halworsen/tdt4295-grafikk/pcb/tdt4295/symlib/kicad-ext-lib/folder description.txt

SN74ALVC245PWR = Octal bus transceiver (for VGA)
BKP2125HS221-T = Ferrite bead, 220 Ohm

Diode_Wurth_150060YS75000 = LED
NUP4114UCW1T2G = TVS diode (ESD)
S25FL127SABMFV101 = Quad-SPI flash

CAPACITORS
T520V337M2R5ATE025 = 330uF

DSC1001AL5-100.0000 = 100MHz clock
