halworsen/tdt4295-grafikk/component documentation/pcbdesign-lecture.pdf

Institutt for datateknologi og informatikk, NTNU

# TDT4295 DATAMASKINER PROSJEKT

## Kretskortutlegg

2021-09-14

## Typisk fremgangsmåte

### 1. Bestem funksjonalitet

I Overordnet skisse over hovedkomponenter

### 2. Bestem hovedkomponenter 3. Tegn skjema for systemet

I Bestem resten av komponentene

### 4. Tegn kretskort

1

## Funksjonalitet

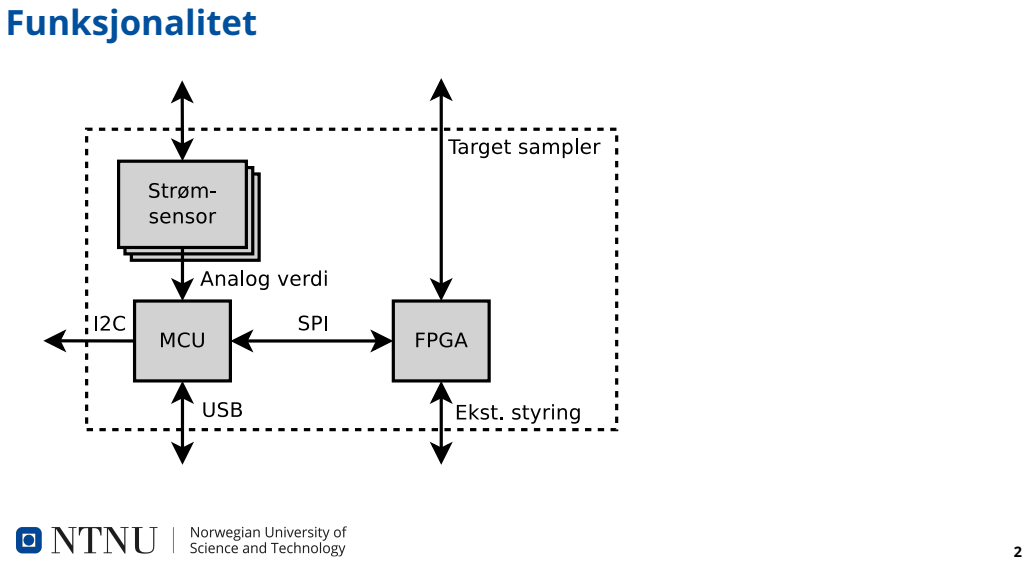
[picture p3: page 3]

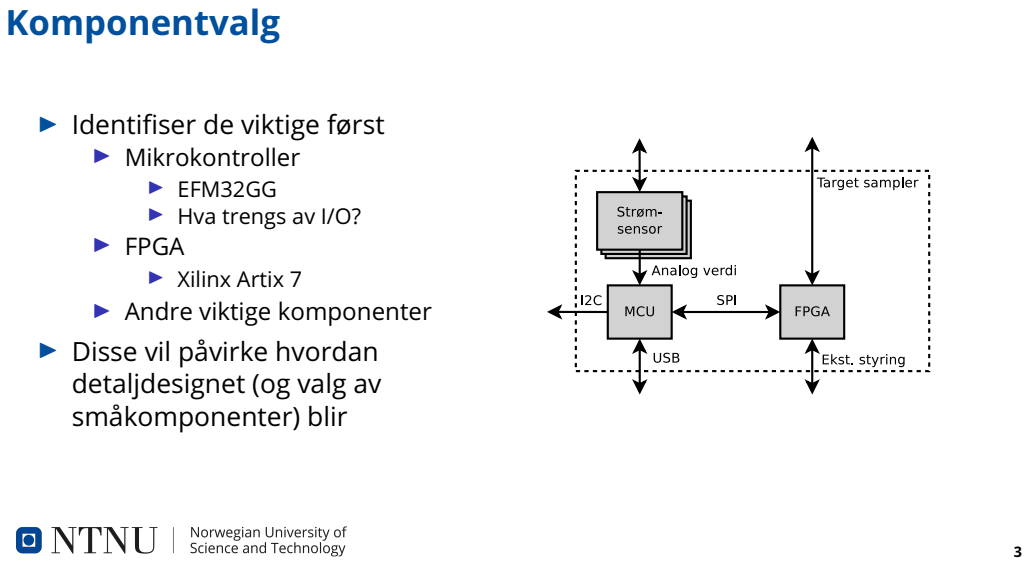
[picture p4: page 4]

Komponentvalg I Identifiser de viktige først I Mikrokontroller I EFM32GG I Hva trengs av I/O? I FPGA I Xilinx Artix 7 I Andre viktige komponenter I Disse vil påvirke hvordan

detaljdesignet (og valg av
småkomponenter) blir

## Komponentvalg

Velg komponenter som er lette å bruke:
I Noen komponenter krever kompliserte støttekretser og / eller komplisert PCB-utlegg
I Noen komponenter kan være vanskelige å skrive programvare for
I Finnes driver som kan brukes?
I Pass på at komponentene faktisk er kompatible med andre komponenter de skal kommunisere med
I Spenningsnivåer: Prøv å holde dere til 3.3V for alle signaler
I Kommunikasjonsstandarder (SPI/I2C/...)
I Les og forstå datablader

4

## Komponentvalg

Velg komponenter som er lette å lodde:
I Samme komponent kan komme i forskjellige pakker I Lette å lodde:
I QFP
I SOIC / *SOP etc
I SOT
I Vanskelige å lodde:
I BGA
I QFN
I Velg stor pitch (avstand mellom pinner/ben)
I Helst 0.5mm eller mer (gjerne 1mm på BGA)
I For motstander/kondensatorer etc:
I Følg databladenes anbefalinger hvis det er angitt I Velg gjerne 0805 eller 1206 som standard
I Unngå mindre enn 0603

5

## Komponentvalg

Velg komponenter som er lette å få tak i:
I Sjekk tilgjengelighet på farnell.no og digikey.no
I Dere har ikke tid til å vente månedsvis på ukurante komponenter

6

## Skjemategning

I KiCAD Eeschema
I Symbolsk sammenkobling av komponenter
I Spesifiserer hvordan komponenter kobles sammen
I Sier ingenting om fysisk plassering, banebredde etc.
I Den viktigste designjobben gjøres her
I Nettlista (informasjon om sammenkobling av komponenter) kan senere overføres til PCB-verktøyet hvor fysisk design gjøres

7

## Skjemategning

I Følg eksempelskjema i datablader
I Det finnes nesten alltid et eksempel som kan kopieres I Bruk hierarkiske bokser/underskjema:
I Mikrokontroller
I FPGA
I Strømforsyning
I ...
I Kjør ERC (Electrical Rules Checker) før dere overfører nettlista til PCB-verktøyet

8

## Symboler

I Symboler representerer en PCB-komponent i skjemaverktøyet I KiCAD har symboler for mange komponenter
I Må du tegne nytt symbol:
I Pass på at pinnenummerering blir korrekt

9

## Avkoblingskondensatorer

I Generelt trenger alle brikker en eller flere avkoblingskondensatorer I Disse skal helst plasseres så nært VCC-pinnene som mulig (på PCB, i skjemategningen spiller det ingen rolle)
I Sørger for å holde VCC konstant selv ved kortvarig høyt strømtrekk I Dette er spesifisert i databladene; kopier eksempelet fra databladet

10

## Ta høyde for feil

I Legg til noen testpunkter for måleutstyr
I Men ikke på raske busser, kan ødelegge signalintegritet I Rut noen ledige GPIO-pinner ut på pin-headere
I Gir fleksibilitet
I Både fra FPGA og mikrokontroller

11

## Koble symbol til footprint

I Når skjemaet er ferdig må alle symboler tilordnes et footprint
I Footprints er den fysiske representasjonen av komponenten
I Inneholder loddpunkter, hull og tekst/grafikk som trykkes på kretskortet
I Hvert symbol i skjemategningen må tilknyttes et footprint som skal brukes i PCB-verkstøyet
I Må du tegne nytt footprint:
I Vær nøyaktig
I Pass på å ikke speilvende pinner
I Følg datablad
I Skriv ut og sjekk at komponenten passer fysisk og at dere har store nok loddepunkter til håndlodding

12

## Kretskortutlegg

I KiCAD: Pcbnew
I Fysisk utlegg av kretskortet
I Plassere komponenter
I Ruting (tegne ledere mellom komponenter)
I Bruker informasjon fra skjemaet slik at man er sikret mot feilkoblinger

13

## PCB: Oppsett av kort

Sett opp antall lag: Bruk 4–8 lag
I Ett internt jordingslag
I Minst ett internt VCC-lag
I Minst to signallag (topp og bunn) I Antall lag:
I Få lag: Billig.
I Mange lag: Lettere å rute
I FPGA er vanskelig å rute med bare 4 lags kort

14

## PCB: Oppsett av kort

Sett opp design rules i KiCAD. Hent info fra fabrikk (https://www.elprint.no/Kapabilitet) eller bruk følgende: I Clearance: 0,125 mm
I Track width: 0,125 mm
I Via dia: 0,6 mm
I En via er en sammenkobling av baner på ett lag til et annet lag I Via drill: 0,3 mm
Det meste kan lages, men husk at smått er dyrt.

15

## PCB: Komponentplassering

I Plasser ut alle footprints manuelt
I Tegn omrisset av kortet når komponentene er plasserte I Ikke lag for lite kort, vanskelig å lodde og debugge
I Tenk nøye gjennom plassering og rotasjon
I Har mye å si for hvor lett ruting blir senere
I Ikke plasser for tett
I Det gir vanskelig ruting og vanskelig lodding
I Grupper komponenter i forhold til skjemategningene I Følg databladenes retningslinjer

16

## PCB: Ruting

I Anbefaler manuell ruting
I Autoruteren gir neppe godt resultat
I Helst ikke bruk minimum banebredde hvis det ikke er nødvendig I Sett opp en standardbredde for signaler, og noen tykkere baner for strømforsyning
I Ikke bruk “buried” eller “blind” via. Bare bruk vanlig through-hole via. I Ikke ha via i en pad

17

## PCB: Signalintegritet

I Plasser krystaller og oscillatorer nær brikkene som bruker de I Hold “høyhastighets”-busser korte og uten hindringer
I Ikke rut disse via en konnektor eller pinheader
I Eksempel: SPI-buss mellom mikrokontroller og FPGA

18

## PCB: Analog og digital

I For minimalt med støy bør eventuell analogdel separeres fra støyende digitale deler
I Legg analogdelen ut mot en kant av PCB
I Ikke mellom strømforsyning og digitaldel
I Vanlig å ha egen VCC for analogdel (se EFM32 AN0002 for eksempel på isolering av analog VCC)
I Stort og komplisert tema
I Ikke noe vi ønsker dere skal bruke mye tid på
I For f.eks audio vil alt fungere (muligens med dårligere lydkvalitet) selv om dere ignorerer alle analog-råd

19

## PCB: Ferdigstillelse

I Fyll alle plan
I De interne jord- og VCC-lagene er såkalte “plan”, store fylte områder med kobber
I Sjekk at ikke via har ødelagt noen av planene
I Kjør DRC (Design Rules Checker)
I Skriv ut på papir og sjekk at:
I komponenter passer fysisk
I det er plass til å lodde

20

## EFM32GG

I Generelt lett å bruke
I Strømforsyning: 3.3V
I Klokke: Kan bruke intern oscillator, eller ekstern krystall I Anbefaler 48MHz ekstern krystall
I Velg den som har de egenskapene dere trenger
I I/O
I Flash (men ingen grunn til å være gjerrig på flash)
I Husk JTAG-konnektor
I Relevante dokumenter:
I SiLabs EFM32 AN0002 (Hardware Design Considerations) I Bruk helst pakke QFP64

21

## EFM32GG

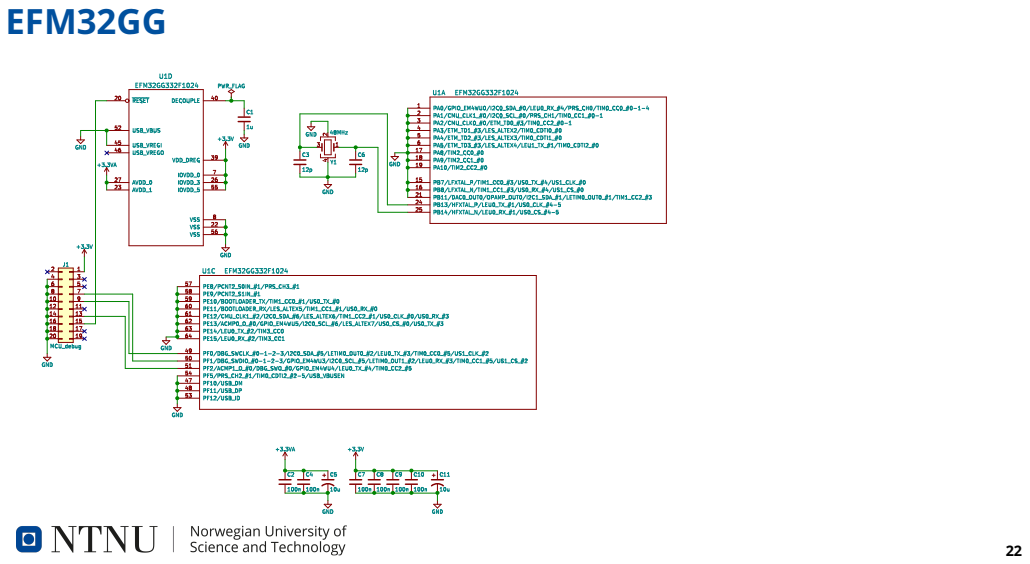
[picture p5: page 23]

## Xilinx Artix 7 FPGA

I Kompleks chip
I Krever mye støtte på kretskortet
I Kompleks strømforsyning
I Mange avkoblinskondensatorer
I Egen Flash-brikke til å lagre konfigurasjonen
I JTAG-konnektor
I Bruk helst pakke FTG256 (også kjent som 256-LBGA)

23

## Artix 7 – Relevante dokumenter

I UG483: 7 Series FPGAs PCB Design Guide
I Her finner dere bl.a. info om avkoblingskondensatorer I XAPP586: Using SPI Flash with 7 Series FPGAs
I Hvordan koble opp Flash-brikken og JTAG-konnektor I UG908: Vivado Design Suite User Guide
I Appendix C har liste over støttede Flash-brikker
I Mindre relevante dokumenter:
I UG470: 7 Series FPGAs Configuration
I Mer om JTAG og konfigurering

24

## Artix 7 – Strømforsyning

I Krever 3 spenninger: 1.0V, 1.8V, 3.3V
I Disse må dere skru på i korrekt rekkefølge
I Switching converter (buck converter) eller lineær? I Switching er mer energieffektiv
I Lineær er enklere å bruke
I Lineær støyer mindre

25

## Artix 7 – Eksempel på strømforsyning

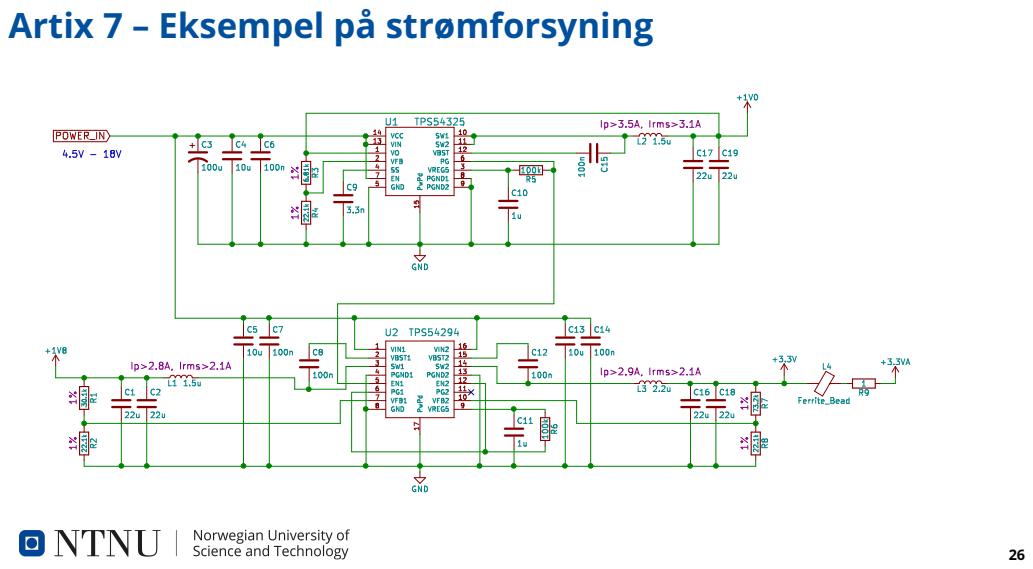
[picture p6: page 27]

## TPS54294 utlegg

27

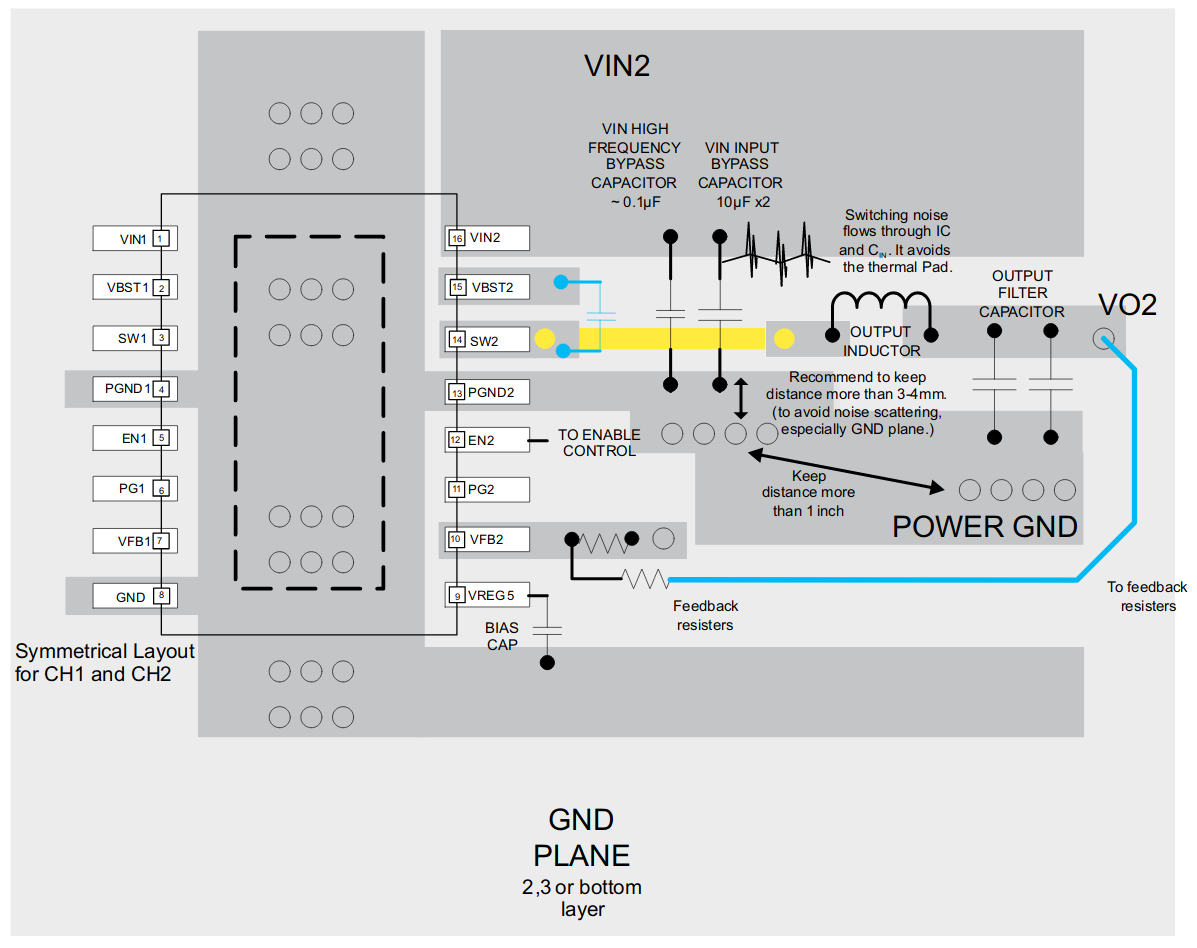
[picture p7: figure]

## Artix 7 – Avkoblingskondensatorer

I Krever mange avkoblingskondensatorer
I Størrelser, antall og maks avstand fra brikken spesifisert i UG483
I En mulighet er å plassere disse på undersiden av kortet, for å oppfylle distansekrav

28

## Artix 7 – Flash

I FPGA trenger en separat Flash-brikke for å lagre konfigurasjonen I Velg en SPI Flash som er kompatibel:
I Velg fra appendix C i UG908
I Kopier skjema fra XAPP586

29

## Artix 7 – JTAG og Reset

I Koble opp som i XAPP586
I Legg til 10k pullup-motstand på TMS og TCK for å hindre problemer når JTAG-kabel ikke er plugget i
I Pullup-motstand er en motstand koblet opp mot VCC. Sørger for at linja er høy hvis ikke noe annet driver den lav.

30

## Artix 7

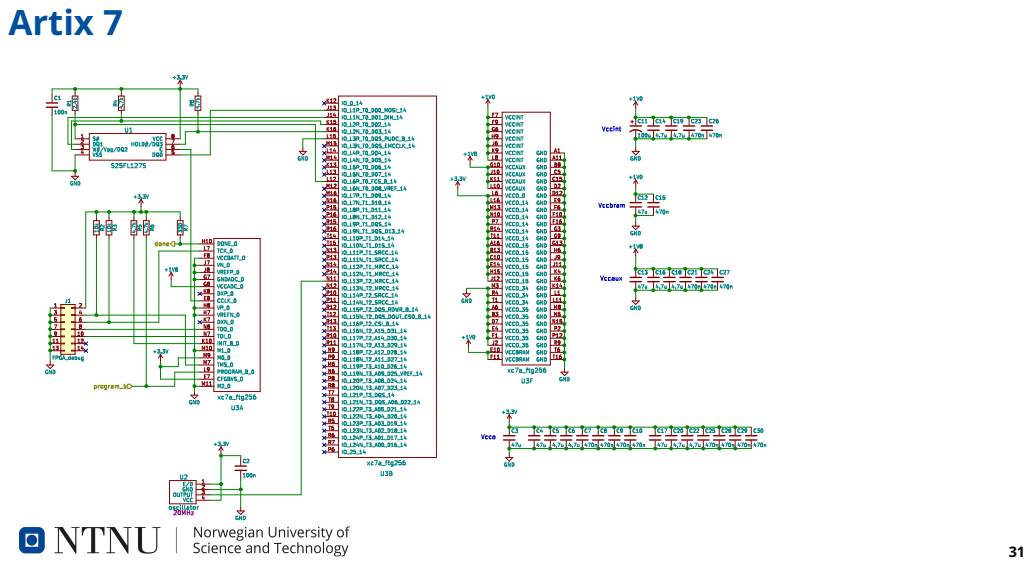
[picture p8: page 32]
