halworsen/tdt4295-grafikk/component documentation/giant-gecko/stk_docs/brd2200/BRD2200A_A03_bom.xlsx

P/N: | BRD2200A
Revision: | A03
Description: | EFM32 Giant Gecko Starter Kit
Revised: | Tuesday, May 15, 2012
Item | Quantity | Reference | Part | Manufacturer | Manufacturers Part Number | Footprint | Tolerance | Rating | Technology | NotMounted | Price1K | Hapro Art.nr | Price_tot
1 | 5 | C100,C101,C718,C1001,C1003 | 1N | Murata | GRM155 | T_0402 |  | 16V | X7R |  | 0.003 |  | 0.015
2 | 44 | C103,C104,C106,C199,C403,C408,C409,C410,C411,C412,C419,C600,C603,C604,C605,C606,C660,C680,C701,C702,C704,C706,C707,C710,C721,C728,C730,C800,C802,C803,C804,C805,C806,C807,C808,C891,C904,C910,C911,C912,C913,C914,C916,C917 | 100N | Murata | GRM155 | T_0402 |  | 16V | X7R |  | 0.003 |  | 0.132
3 | 16 | C105,C404,C415,C423,C601,C607,C700,C703,C714,C719,C720,C725,C731,C732,C907,C915 | 10U | Murata | GRM21 | T_0805 |  | 10V | X5R |  | 0.03 |  | 0.48
4 | 1 | C198 | 330P | Murata | GRM155 | T_0402 |  | 50V | C0G |  | 0.003 |  | 0.003
5 | 1 | C200 | 30mF | Tayio Yuden | PAS311HR-VA6R | TAIYO_YUDEN_311_VA6R |  | 3.3V |  |  | 0.335 |  | 0.335
6 | 1 | C250 | 100N | Murata | GRM188 | T_0603 |  | 16V | X7R | NM | 0.003 |  | 0
7 | 4 | C400,C401,C420,C501 | 1U | Murata | GRM18 | T_0603 |  | 10V | X5R |  | 0.006 |  | 0.024
8 | 1 | C402 | 4U7 | Murata | GRM21 | T_0805 |  | 25V | X5R |  | 0.046 |  | 0.046
9 | 6 | C405,C406,C890,C905,C908,C909 | 10N | Murata | GRM155 | T_0402 |  | 16V | X7R |  | 0.013 |  | 0.078
10 | 2 | C417,C418 | 7P5 | Murata | GRM15 | T_0402 |  | 50V | C0G |  | 0.005 |  | 0.01
11 | 4 | C421,C422,C900,C901 | 18P | Murata | GCM155 | T_0402 |  | 50V | C0G |  | 0.003 |  | 0.012
12 | 1 | C500 | 22N | Murata | GRM155 | T_0402 |  | 16V | X7R |  | 0.003 |  | 0.003
13 | 2 | C602,C705 | 33N | Murata | GRM155 | T_0402 |  | 16V | X7R |  | 0.003 |  | 0.006
14 | 2 | C724,C920 | 100N | Murata | GRM155 | T_0402 |  | 16V | X7R |  | 0.013 |  | 0.026
15 | 1 | C729 | 10N | Murata | GRM155 | T_0402 |  | 16V | X7R | NM | 0.013 |  | 0
16 | 2 | C902,C903 | 12P | Murata | GCM155 | T_0402 |  | 50V | C0G |  | 0.003 |  | 0.006
17 | 2 | C1002,C1004 | 10P | Murata | GRM155 | T_0402 |  | 50V | C0G |  | 0.003 |  | 0.006
18 | 2 | D400,D600 | IP4220CZ6 | NXP Semiconductors | IP4220CZ6,125 | SOT457 |  |  |  |  | 0.1 |  | 0.2
19 | 1 | D800 | VESD05A8A-HNH | Vishay Semiconductors | VESD05A8A-HNH | LLP1713-9L |  |  |  |  | 0.25 |  | 0.25
20 | 1 | J100 | 1X5 2.54MM | FCI | 68000-408HLF | HEADER5X1_2.54MM_TH |  |  |  | NM | 0.11 |  | 0
21 | 1 | LCD1 | CL010-1087-04 | Tri-T Co Ltd | CL010-1087-04 | LCD_TRI-T_CL010-1087-03 |  |  |  |  | 2.2 |  | 2.2
22 | 3 | LED100,LED101,LED900 | YELLOW | Würth Electronics | 150060YS75000 | LED_0603 |  |  |  |  | 0.019 |  | 0.057
23 | 1 | LED901 | BLUE | Panasonic | LNJ926W8CRA | LED_0603 |  |  |  |  | 0.247 | 9141170 | 0.247
24 | 1 | LED903 | RED | Würth Electronics | 150060RS75000 | LED_0603 |  |  |  |  | 0.028 |  | 0.028
25 | 1 | LED904 | LED_G_R | Avago | HSMF-C165 | AVAGO_HSMF_C165 |  |  |  |  | 0.133 | 9141206 | 0.133
26 | 1 | L100 | 390UH | Würth Electronics | S11100017 | SDR0302 |  |  |  |  | 0.072 |  | 0.072
27 | 8 | L400,L700,L730,L780,L800,L801,L900,L1001 | CBF102WB | Würth Electronics | 74279266 | WURTH_CBF_0603 |  |  |  |  | 0.017 |  | 0.136
28 | 3 | L401,L402,L600 | CBF221HC | Würth Electronics | 742792022 | COIL_MUR_BLM21_0805 |  |  |  |  | 0.017 |  | 0.051
29 | 1 | M1 | HOLE_PTH_3MM |  |  | 3MM_PLATED |  |  |  | NM |  |  | 0
30 | 2 | M2,M3 | HOLE_TH_3MM |  |  | 3MM_NONPLATED |  |  |  | NM |  |  | 0
31 | 1 | PCB1 | PCB2200 |  | PCB2200 Rev. A03 | N/A |  |  |  |  |  |  | 0
32 | 1 | P100 | HEADER_2X10_2.54MM_HOR_SMD | Taitek | HE2-20G6C394-5R | HEADER_2X10_2.54MM_HOR_SMD |  |  |  |  | 0.71 |  | 0.71
33 | 1 | P200 | HEADER_2X10_1.27MM_SMD | Sullins | GRPB102VWQS | HEADER_2X10_1.27MM_SMD |  |  |  | NM | 0.73 | 9322374 | 0
34 | 1 | P400 | USB_Micro_AB | Hirose Electric Co Ltd | ZX62-AB-5PA(11) | ZX62-AB-5PA_11 |  |  |  |  | 0.5 |  | 0.5
35 | 1 | P601 | WR_COM_USB_MINI_B | Würth Electronics | 651 005 161 21 | WURTH_USB_65100516121 |  |  |  |  | 0.242 |  | 0.242
36 | 1 | P700 | COIN_CELL | Keystone | 3002 | KEYSTONE_3002 |  |  |  |  | 0.23 |  | 0.23
37 | 1 | P800 | HEADER_2.54MM_SMD_SHROUD | Würth Electronics | 612 3 020 206 21 | HEADER_2X10_2.54MM_SMD_SHROUD |  |  |  |  | 0.674 |  | 0.674
38 | 1 | P900 | HEADER_2X10_2.54MM_SMD | FCI | 95278-801A20LF | HEADER_2X10_2.54MM_SMD |  |  |  | NM | 0.73 |  | 0
39 | 1 | Q1 | BSS138W | Diodes Inc. | BSS138W-7-F | SOT323 |  |  |  |  | 0.07 |  | 0.07
40 | 1 | Q100 | TEMT6200FX01 | Vishay | TEMT6200FX01A | T_0805 |  |  |  |  | 0.41 |  | 0.41
41 | 1 | Q702 | BC846BWT1G | ON Semiconductor | BC846BWT1G | SC70_SOT323 |  |  |  |  | 0.046 |  | 0.046
42 | 1 | Q703 | NTS210 | ON Semiconductor | NTS2101PT1G | SC-70 |  |  |  |  | 0.12 |  | 0.12
43 | 2 | RP800,RP801 | 33R | ROHM | MNR04M0APJ330 | RES_MNR04-8 |  |  |  |  | 0.0122 |  | 0.0244
44 | 8 | R100,R103,R246,R401,R728,R730,R750,R810 | 100R |  |  | T_0402 |  |  |  |  | 0.005 |  | 0.04
45 | 12 | R101,R102,R106,R407,R409,R680,R681,R682,R686,R687,R708,R815 | 1M |  |  | T_0402 |  |  |  |  | 0.005 |  | 0.06
46 | 6 | R104,R607,R608,R774,R807,R808 | 4K7 |  |  | T_0402 |  |  |  |  | 0.005 |  | 0.03
47 | 12 | R105,R603,R604,R605,R606,R729,R802,R803,R804,R809,R890,R891 | 100K |  |  | T_0402 |  |  |  |  | 0.005 |  | 0.06
48 | 3 | R107,R108,R900 | 3K |  |  | T_0402 |  |  |  |  | 0.005 |  | 0.015
49 | 2 | R196,R901 | 1K5 |  |  | T_0402 |  |  |  |  | 0.005 |  | 0.01
50 | 6 | R198,R408,R704,R779,R915,R916 | 0R |  |  | T_0402 |  |  |  |  | 0.005 |  | 0.03
51 | 1 | R199 | 22K |  |  | T_0402 |  |  |  |  | 0.005 |  | 0.005
52 | 4 | R240,R243,R244,R245 | 10K |  |  | T_0603 |  |  |  | NM | 0.005 |  | 0
53 | 2 | R241,R242 | 0R |  |  | T_0603 |  |  |  |  | 0.005 |  | 0.01
54 | 3 | R403,R731,R910 | 1R |  |  | T_0402 |  |  |  |  | 0.005 |  | 0.015
55 | 2 | R405,R406 | 15R |  |  | T_0402 |  |  |  |  | 0.005 |  | 0.01
56 | 1 | R410 | 0R |  |  | T_0402 |  |  |  | NM | 0.005 |  | 0
57 | 6 | R600,R609,R612,R700,R800,R914 | 10K |  |  | T_0402 |  |  |  |  | 0.005 |  | 0.03
58 | 3 | R601,R611,R702 | 180K |  |  | T_0402 |  |  |  |  | 0.005 |  | 0.015
59 | 2 | R602,R703 | 110K |  |  | T_0402 |  |  |  |  | 0.005 |  | 0.01
60 | 2 | R610,R814 | 10M |  |  | T_0402 |  |  |  |  | 0.005 |  | 0.01
61 | 1 | R701 | 4R7 | Bourns | CRT1206-BY-4R7-ELFTR | T_1206 | 0.10% |  |  |  | 0.15 | 9170471 | 0.15
62 | 5 | R705,R772,R792,R919,R920 | 1K |  |  | T_0402 |  |  |  |  | 0.005 |  | 0.025
63 | 1 | R706 | 15K |  |  | T_0402 |  |  |  |  | 0.005 |  | 0.005
64 | 1 | R707 | 33K |  |  | T_0402 |  |  |  |  | 0.005 |  | 0.005
65 | 2 | R709,R710 | 1K8 | YAGEO | RT0603BRD071K8L | T_0603 | 0.10% |  |  |  | 0.036 |  | 0.072
66 | 1 | R717 | 10R |  |  | T_0402 |  |  |  |  | 0.005 |  | 0.005
67 | 1 | R718 | 12K | YAGEO | RT0603BRD0712KL | T_0603 | 0.10% |  |  |  | 0.036 |  | 0.036
68 | 2 | R727,R801 | 47K |  |  | T_0402 |  |  |  |  | 0.005 |  | 0.01
69 | 4 | R732,R781,R805,R806 | 33R |  |  | T_0402 |  |  |  |  | 0.005 |  | 0.02
70 | 1 | R760 | 330K |  |  | T_0603 | 1% |  |  |  | 0.005 |  | 0.005
71 | 2 | R902,R904 | 22R |  |  | T_0402 |  |  |  |  | 0.005 |  | 0.01
72 | 2 | R903,R912 | 2K |  |  | T_0402 |  |  |  |  | 0.005 |  | 0.01
73 | 2 | R917,R918 | 4K7 |  |  | T_0402 |  |  |  | NM | 0.005 |  | 0
74 | 2 | R1002,R1007 | 6K2 |  |  | T_0402 |  |  |  |  | 0.005 |  | 0.01
75 | 2 | R1003,R1008 | 62R |  |  | T_0402 |  |  |  |  | 0.005 |  | 0.01
76 | 3 | R1004,R1009,R1010 | 51K | YAGEO | RT0603BRD0751KL | T_0603 | 0.10% |  |  |  | 0.036 |  | 0.108
77 | 1 | R1005 | 160R | YAGEO | RT0603BRD07160RL | T_0603 | 0.10% |  |  |  | 0.036 |  | 0.036
78 | 1 | ST700 | HEADER_2X2_2.54MM_TH |  |  | HEADER_2X2_2.54MM_TH |  |  |  | NM |  |  | 0
79 | 3 | SW100,SW101,SW400 | WS_TSS_6X6MM_SMD | Würth Electronics | 430182043816 | SWITCH_WURTH_4301182043816 |  |  |  |  | 0.26 |  | 0.78
80 | 1 | SW700 | SW_DP3T | ALPS | SSSS223600 | SW_CK_JS203011 |  |  |  |  | 0.28 |  | 0.28
81 | 1 | T1 | TOUCH SLIDER |  |  | SLIDER_7x28_4SEG |  |  |  |  | 0 |  | 0
82 | 1 | U1 | EFM32GG990F1024 | Energy Micro | EFM32GG990F1024 Rev.D | EFM32GG_BGA112 |  |  |  |  |  |  | 0
83 | 1 | U100 | NAND256W3A | Numonyx | NAND256W3A2BZA6E | VFBGA55_8X10MM |  |  |  |  | 2.23 |  | 2.23
84 | 1 | U101 | TS5A3166 | Texas Instruments | TS5A3166DCKR | SC70-5 |  |  |  |  | 0.22 |  | 0.22
85 | 1 | U400 | AP2151 | Diodes Inc. | AP2151FMG-7 | AP2161_DFN6 |  |  |  |  | 0.26 |  | 0.26
86 | 1 | U600 | LP3982ILD-ADJ | National Semiconductor | LP3982ILDX-ADJ | LLP8 |  |  |  |  | 0.4 |  | 0.4
87 | 4 | U602,U695,U702,U805 | TS3A4751 | Texas Instruments | TS3A4751RUCR | QFN14_M040_W2.0 |  |  |  |  | 0.4 | 9122682 | 1.6
88 | 3 | U660,U803,U804 | SN74LVC2G125DC | Texas Instruments | SN74LVC2G125DCUR | VSSOP8 |  |  |  |  | 0.1725 |  | 0.5175
89 | 1 | U700 | TS5A3159A | Texas Instruments | TS5A3159ADBVR | SOT23_6 |  |  |  |  | 0.1862 |  | 0.1862
90 | 1 | U701 | LP3982ILD-ADJ | National Semiconductor | LP3982ILDX-ADJ | LLP8 |  |  |  |  | 0.308 |  | 0.308
91 | 1 | U703 | LTC6102CDD | National Semiconductor | LTC6102CDD#PBF | DFN8 |  |  |  |  | 1.72 | 9113383 | 1.72
92 | 2 | U706,U707 | MCP6001T | Microchip Technology | MCP6001T-I/OT | SOT23-5 |  |  |  |  | 0.18 |  | 0.36
93 | 3 | U800,U802,U806 | 74LVC4066 | NXP | 74LVC4066BQ | NXP_DHVQFN14 |  |  |  |  | 0.4 |  | 1.2
94 | 1 | U801 | 74LVC16T245 | Texas Instruments | 74LVC16T245DGG | TSSOP48_M050_W6.1 |  |  |  |  | 1.01 |  | 1.01
95 | 1 | U1000 | AD8656 | Analog Devices Inc | AD8656ARMZ | MSOP8 |  |  |  |  | 1.55 |  | 1.55
96 | 1 | X400 | 48.0MHz | NDK | NX5032GA-48.000M | NDK_NX5032GA |  |  |  |  | 0.29 |  | 0.29
97 | 1 | X401 | 32.768kHz | Micro Crytstal AG | MS3V-T1R 32.768kHz 12.5pF | MS3V-T1R |  |  |  |  | 0.2 |  | 0.2
