halworsen/tdt4295-grafikk/mcu/application/model_generation/star.obj

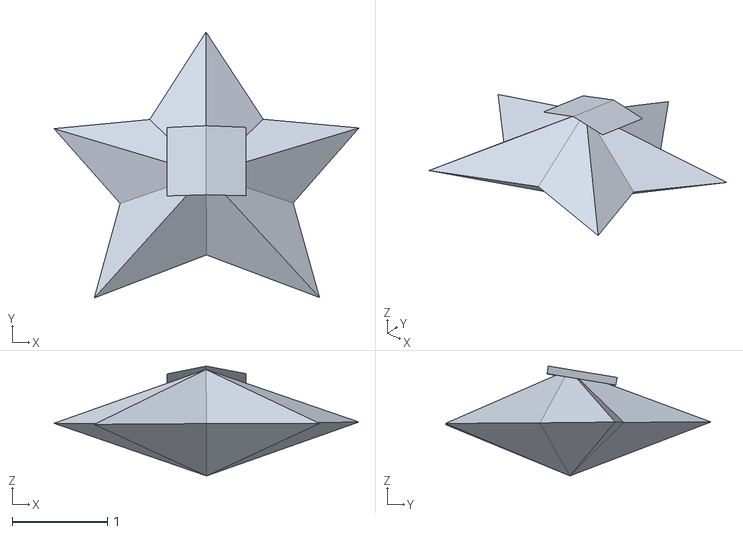
[picture p10: CAD file, 2021-11-22]
mcu/application/model_generation/star.obj
3.21 x 2.80 x 1.15
