halworsen/tdt4295-grafikk/pcb/tdt4295/models/120300727-659-dm1aa-sf-pej_21_/dm1aa-sf-pej_21_.stp

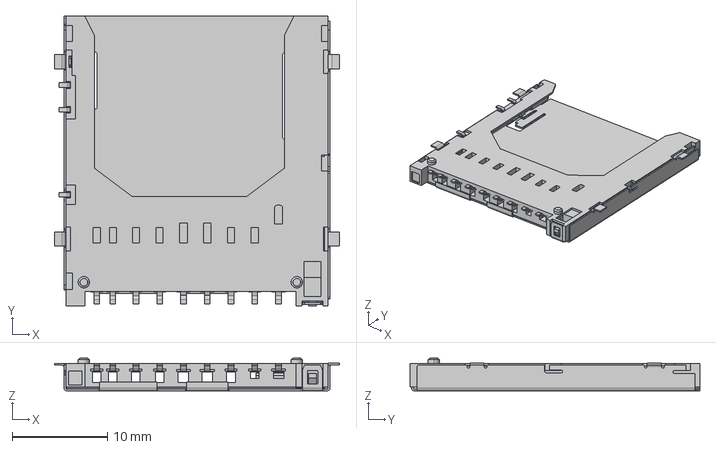
[picture p11: CAD file, 2021-10-03]
pcb/tdt4295/models/120300727-659-dm1aa-sf-pej_21_/dm1aa-sf-pej_21_.stp
30.0 x 30.5 x 3.45 mm
