halworsen/tdt4295-grafikk/pcb/tdt4295/models/690-005-299-043/690-005-299-043--3DModel-STEP-56544.STEP

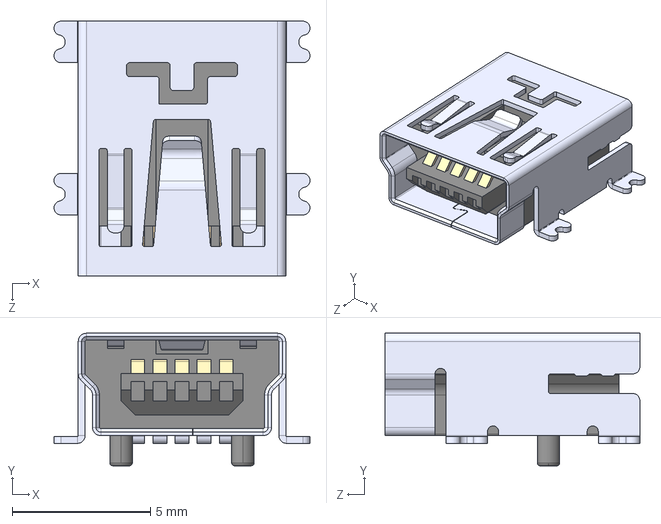
[picture p12: CAD file, 2021-10-03]
pcb/tdt4295/models/690-005-299-043/690-005-299-043--3DModel-STEP-56544.STEP
9.25 x 4.79 x 9.20 mm
