halworsen/tdt4295-grafikk/pcb/tdt4295/models/ABM11-48MHZ-D2X-T3/ABM11-48.000MHZ-D2X-T3--3DModel-STEP-400430.STEP

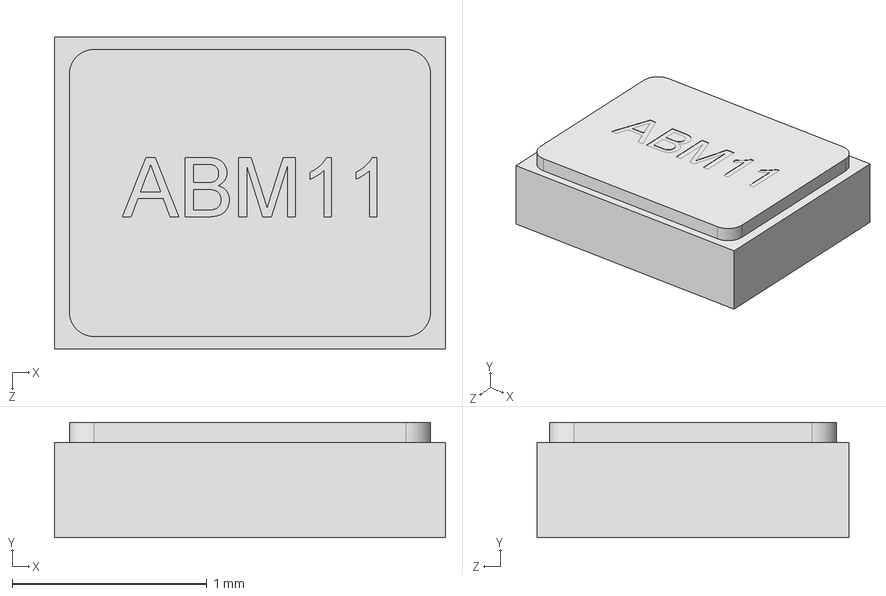
[picture p13: CAD file, 2021-10-03]
pcb/tdt4295/models/ABM11-48MHZ-D2X-T3/ABM11-48.000MHZ-D2X-T3--3DModel-STEP-400430.STEP
2.01 x 0.59 x 1.60 mm
