halworsen/tdt4295-grafikk/pcb/tdt4295/models/COM-09032/COM-09032--3DModel-STEP-56544.STEP

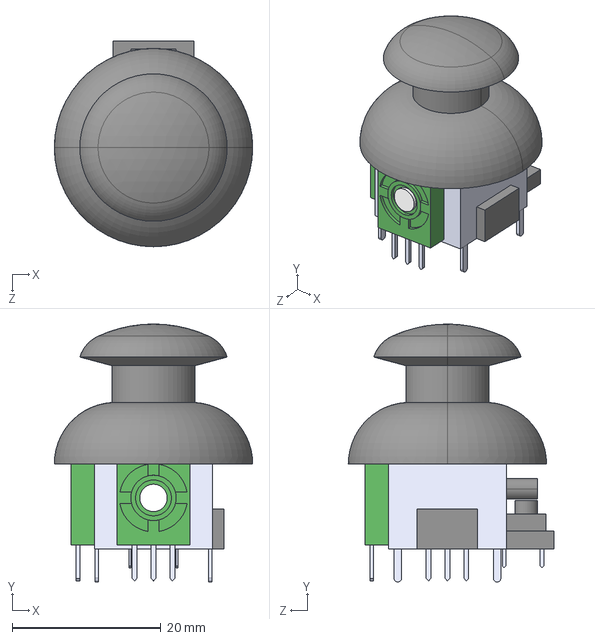
[picture p14: CAD file, 2021-09-25]
pcb/tdt4295/models/COM-09032/COM-09032--3DModel-STEP-56544.STEP
26.7 x 34.7 x 27.6 mm
