halworsen/tdt4295-grafikk/pcb/tdt4295/models/TS-1102S-B-B-B--3DModel-STEP-56544.STEP

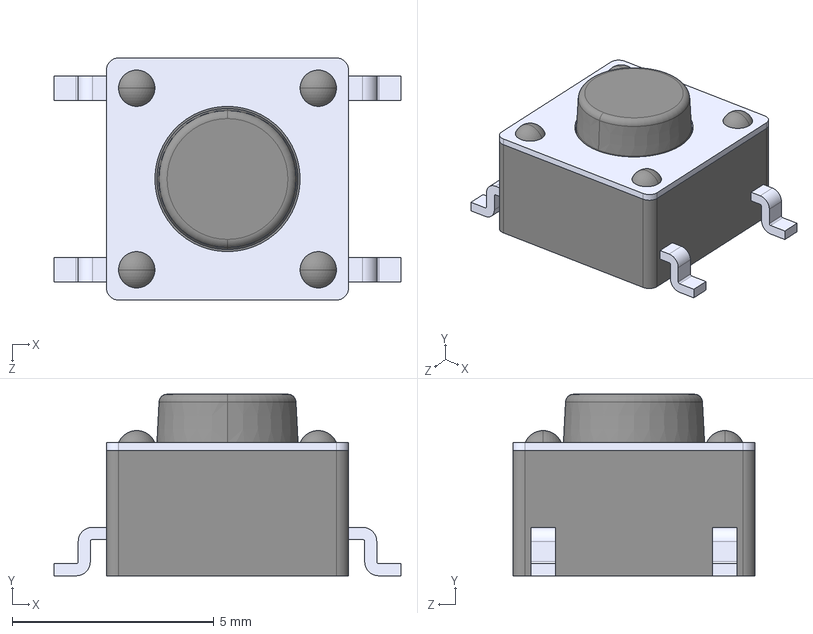
[picture p15: CAD file, 2021-10-03]
pcb/tdt4295/models/TS-1102S-B-B-B--3DModel-STEP-56544.STEP
8.60 x 4.50 x 6.00 mm
