halworsen/tdt4295-grafikk/pcb/tdt4295/models/XC7A100T/XC7A100T-2FTG256I.STEP

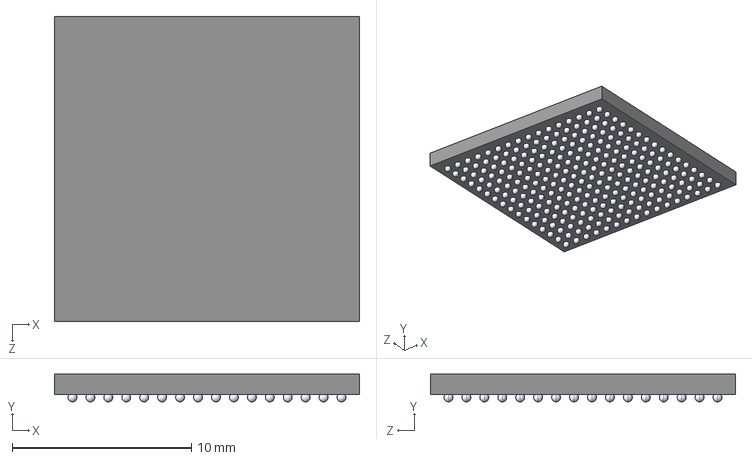
[picture p16: CAD file, 2021-10-03]
pcb/tdt4295/models/XC7A100T/XC7A100T-2FTG256I.STEP
17.0 x 1.55 x 17.0 mm
