halworsen/tdt4295-grafikk/mcu/application/model_generation/arwing.obj

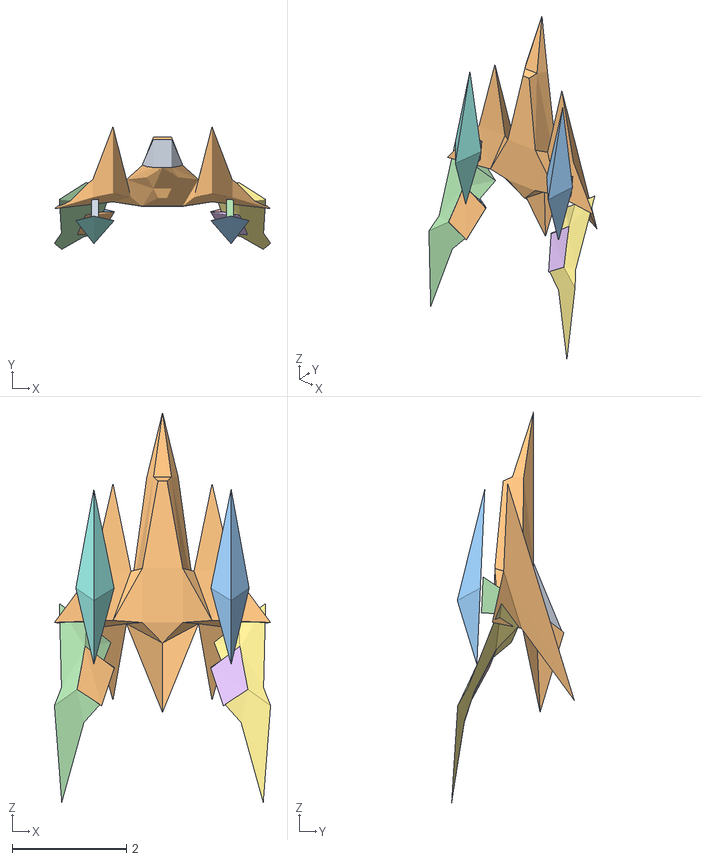
[picture p17: CAD file, 2021-11-22]
mcu/application/model_generation/arwing.obj
3.78 x 2.15 x 6.82
Mesh1 Group1 skp743B1 Model
Mesh2 Group2 skp743B1 Model
Mesh3 skp743B1 Model
Mesh4 skp743B1 Model
Mesh5 skp743B1 Model
Mesh6 skp743B1 Model
Mesh7 skp743B1 Model
Mesh8 skp743B1 Model
Mesh9 skp743B1 Model
Mesh10 skp743B1 Model
Mesh11 skp743B1 Model
Mesh12 skp743B1 Model
