halworsen/tdt4295-grafikk/mcu/application/model_generation/smash_mario.obj

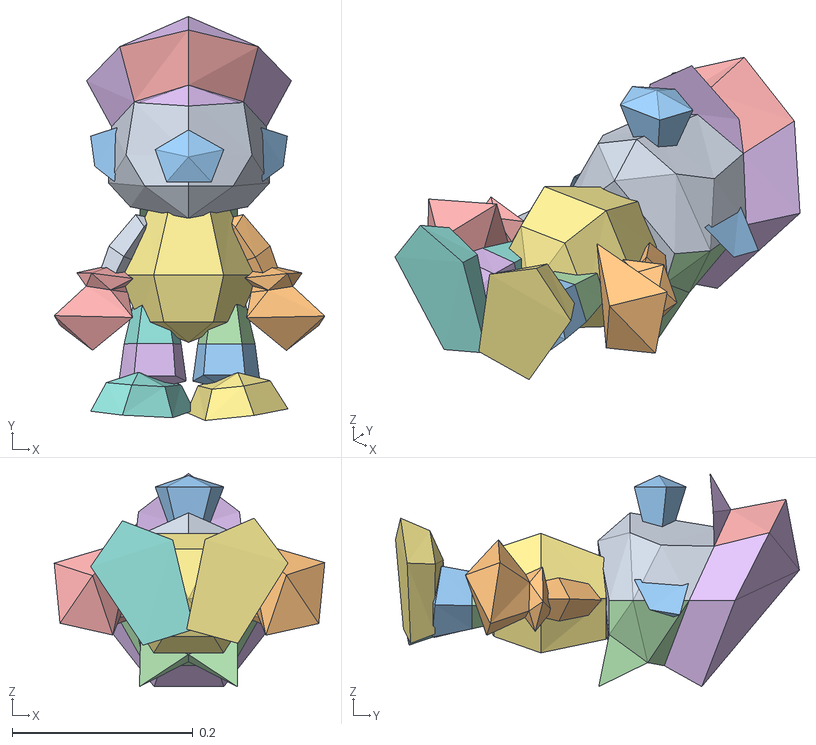
[picture p18: CAD file, 2021-11-22]
mcu/application/model_generation/smash_mario.obj
0.299 x 0.446 x 0.236
armr_0_0_150
arml_0_0_151
head_0_0_152
head_0_0_153
head_2D4B2E3B_0_072
legr_0_0_154
body_128A33CA_0_067
legr_0_0_155
head_5B016C9B_0_070
arml_0_0_156
legl_0_0_157
legl_0_0_158
armr_0_0_159
head_0_0_160
legl_0_0_161
legr_0_0_162
armr_0_0_163
arml_0_0_164
