halworsen/tdt4295-grafikk/mcu/application/model_generation/peaches_castle.obj

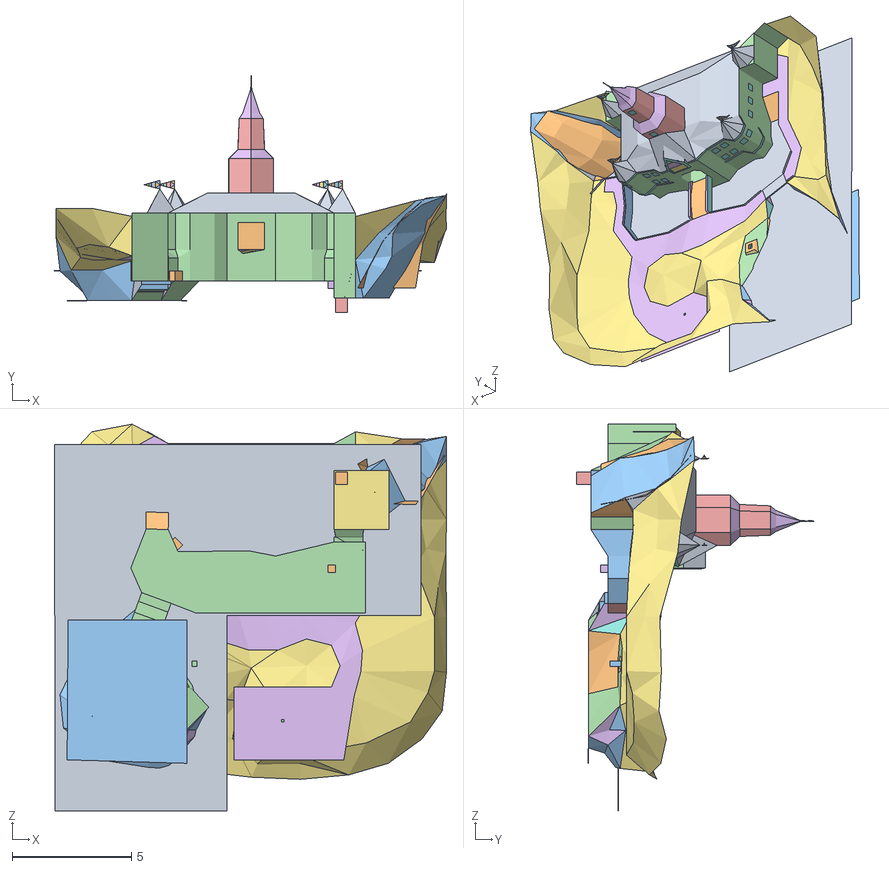
[picture p19: CAD file, 2021-11-22]
mcu/application/model_generation/peaches_castle.obj
16.4 x 9.96 x 16.2
Shape_IndexedFaceSet_137_Shape_IndexedFaceSet.259
Shape_IndexedFaceSet_136_Shape_IndexedFaceSet.258
Shape_IndexedFaceSet_132_Shape_IndexedFaceSet.254
Shape_IndexedFaceSet_131_Shape_IndexedFaceSet.253
Shape_IndexedFaceSet_127_Shape_IndexedFaceSet.249
Shape_IndexedFaceSet_111_Shape_IndexedFaceSet.233
Shape_IndexedFaceSet_110_Shape_IndexedFaceSet.232
Shape_IndexedFaceSet_109_Shape_IndexedFaceSet.231
Shape_IndexedFaceSet_108_Shape_IndexedFaceSet.230
Shape_IndexedFaceSet_107_Shape_IndexedFaceSet.229
Shape_IndexedFaceSet_106_Shape_IndexedFaceSet.228
Shape_IndexedFaceSet_105_Shape_IndexedFaceSet.227
Shape_IndexedFaceSet_104_Shape_IndexedFaceSet.226
Shape_IndexedFaceSet_103_Shape_IndexedFaceSet.225
Shape_IndexedFaceSet_102_Shape_IndexedFaceSet.224
Shape_IndexedFaceSet_101_Shape_IndexedFaceSet.223
Shape_IndexedFaceSet_100_Shape_IndexedFaceSet.222
Shape_IndexedFaceSet_099_Shape_IndexedFaceSet.221
Shape_IndexedFaceSet_098_Shape_IndexedFaceSet.220
Shape_IndexedFaceSet_097_Shape_IndexedFaceSet.219
Shape_IndexedFaceSet_096_Shape_IndexedFaceSet.218
Shape_IndexedFaceSet_095_Shape_IndexedFaceSet.217
Shape_IndexedFaceSet_094_Shape_IndexedFaceSet.216
Shape_IndexedFaceSet_093_Shape_IndexedFaceSet.215
Shape_IndexedFaceSet_092_Shape_IndexedFaceSet.214
Shape_IndexedFaceSet_091_Shape_IndexedFaceSet.213
Shape_IndexedFaceSet_090_Shape_IndexedFaceSet.212
Shape_IndexedFaceSet_089_Shape_IndexedFaceSet.211
Shape_IndexedFaceSet_088_Shape_IndexedFaceSet.210
Shape_IndexedFaceSet_087_Shape_IndexedFaceSet.209
Shape_IndexedFaceSet_086_Shape_IndexedFaceSet.208
Shape_IndexedFaceSet_085_Shape_IndexedFaceSet.207
Shape_IndexedFaceSet_084_Shape_IndexedFaceSet.206
Shape_IndexedFaceSet_083_Shape_IndexedFaceSet.205
Shape_IndexedFaceSet_082_Shape_IndexedFaceSet.204
Shape_IndexedFaceSet_072_Shape_IndexedFaceSet.194
Shape_IndexedFaceSet_071_Shape_IndexedFaceSet.193
Shape_IndexedFaceSet_070_Shape_IndexedFaceSet.192
Shape_IndexedFaceSet_046_Shape_IndexedFaceSet.168
Shape_IndexedFaceSet_045_Shape_IndexedFaceSet.167
Shape_IndexedFaceSet_044_Shape_IndexedFaceSet.166
Shape_IndexedFaceSet_043_Shape_IndexedFaceSet.165
Shape_IndexedFaceSet_042_Shape_IndexedFaceSet.164
Shape_IndexedFaceSet_041_Shape_IndexedFaceSet.163
Shape_IndexedFaceSet_040_Shape_IndexedFaceSet.162
Shape_IndexedFaceSet_039_Shape_IndexedFaceSet.161
Shape_IndexedFaceSet_038_Shape_IndexedFaceSet.160
Shape_IndexedFaceSet_037_Shape_IndexedFaceSet.159
Shape_IndexedFaceSet_036_Shape_IndexedFaceSet.158
Shape_IndexedFaceSet_035_Shape_IndexedFaceSet.157
Shape_IndexedFaceSet_034_Shape_IndexedFaceSet.156
Shape_IndexedFaceSet_033_Shape_IndexedFaceSet.155
Shape_IndexedFaceSet_032_Shape_IndexedFaceSet.154
Shape_IndexedFaceSet_031_Shape_IndexedFaceSet.153
Shape_IndexedFaceSet_030_Shape_IndexedFaceSet.152
Shape_IndexedFaceSet_029_Shape_IndexedFaceSet.151
Shape_IndexedFaceSet_028_Shape_IndexedFaceSet.150
Shape_IndexedFaceSet_027_Shape_IndexedFaceSet.149
Shape_IndexedFaceSet_026_Shape_IndexedFaceSet.148
Shape_IndexedFaceSet_025_Shape_IndexedFaceSet.147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
