halworsen/tdt4295-grafikk/mcu/application/model_generation/N64_mario.obj

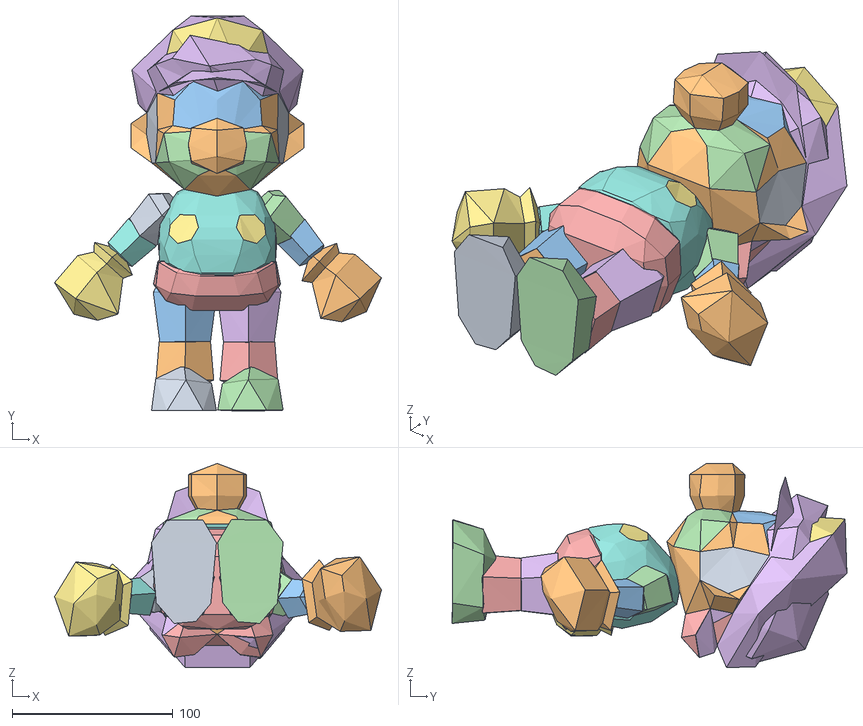
[picture p20: CAD file, 2021-11-22]
mcu/application/model_generation/N64_mario.obj
203.7 x 246.1 x 127.2
Right_Foot
Right_Lower_Leg
Right_Upper_Leg
Left_Foot
Left_Lower_Leg
Left_Upper_Leg
Right_Hand
Right_Lower_Arm
Right_Upper_Arm
Left_Hand
Left_Lower_Arm
Left_Upper_Arm
Abdomen
Hair_Cap
Buttons
Chest
Hair_Piece
Eyes
Moustache
Hair
Cap
Logo
