halworsen/tdt4295-grafikk/mcu/application/model_generation/mariohead.obj

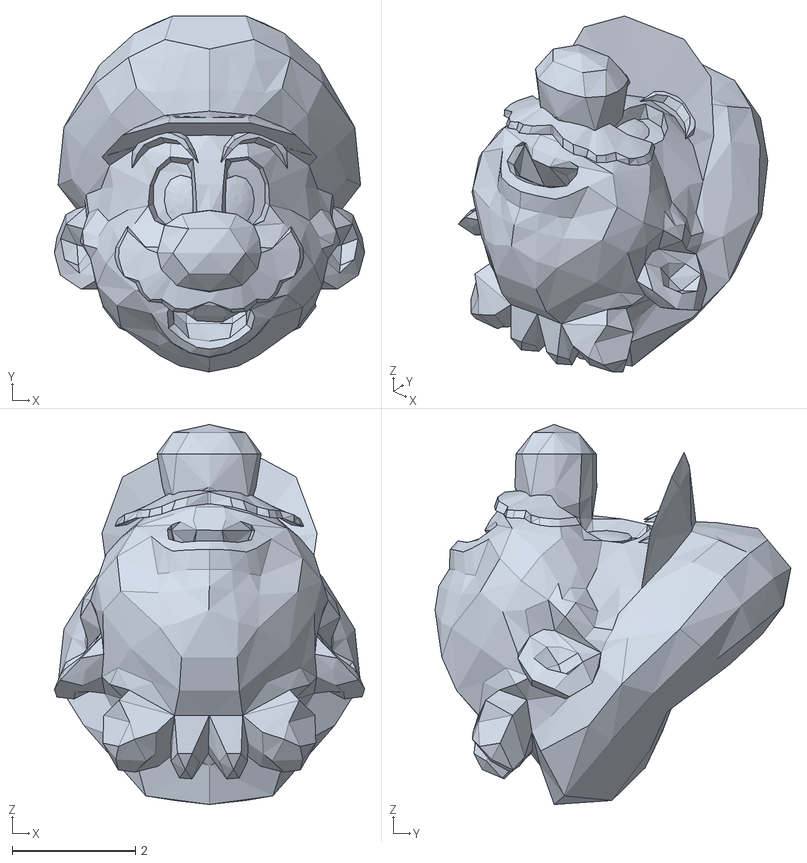
[picture p21: CAD file, 2021-11-22]
mcu/application/model_generation/mariohead.obj
5.03 x 5.76 x 6.16
