halworsen/tdt4295-grafikk/mcu/application/model_generation/torchic.obj

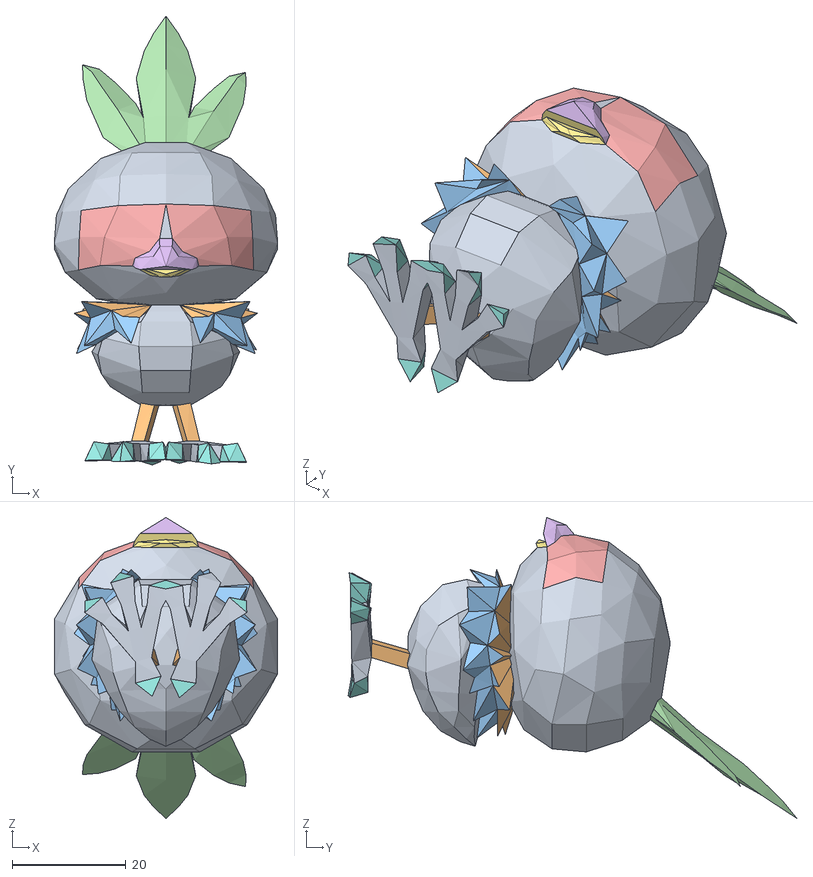
[picture p22: CAD file, 2021-11-22]
mcu/application/model_generation/torchic.obj
39.2 x 78.8 x 52.8
RefRep_314
RefRep_316
RefRep_318
RefRep_320
RefRep_322
RefRep_324
RefRep_326
RefRep_328
RefRep_330
