halworsen/tdt4295-grafikk/mcu/application/model_generation/link.obj

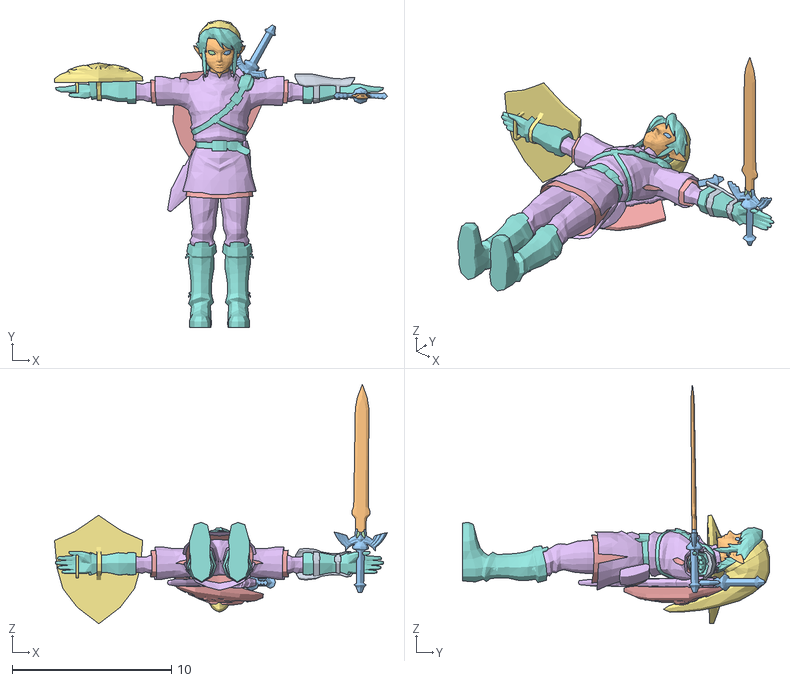
[picture p23: CAD file, 2021-11-22]
mcu/application/model_generation/link.obj
20.9 x 19.3 x 15.0
