halworsen/tdt4295-grafikk/pcb/tdt4295/models/TPS54294/TPS54294PWPR.STEP

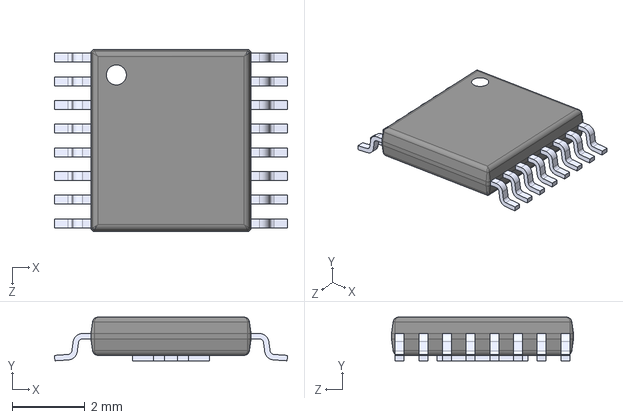
[picture p24: CAD file, 2021-10-03]
pcb/tdt4295/models/TPS54294/TPS54294PWPR.STEP
6.40 x 1.20 x 5.00 mm
