halworsen/tdt4295-grafikk/component documentation/other boards/pmod-vga/Filer_for_Pmod VGA Reference Manual - Digilent Reference/figure-1-color-crt-display.png

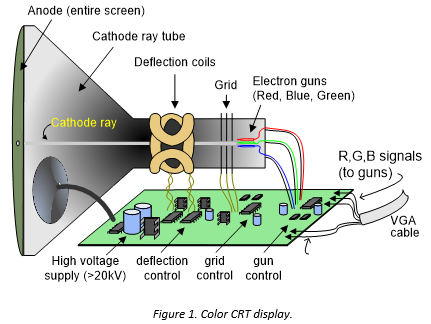
component documentation/other boards/pmod-vga/Filer_for_Pmod VGA Reference Manual - Digilent Reference/figure-1-color-crt-display.png
