halworsen/tdt4295-grafikk/component documentation/other boards/pmod-vga/Filer_for_Pmod VGA Reference Manual - Digilent Reference/figure-4-vga-display-controller-block-diagram.png

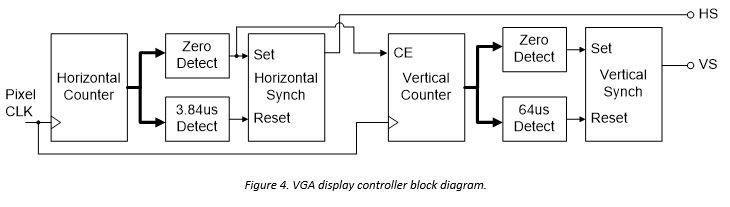
component documentation/other boards/pmod-vga/Filer_for_Pmod VGA Reference Manual - Digilent Reference/figure-4-vga-display-controller-block-diagram.png
