halworsen/tdt4295-grafikk/component documentation/other boards/pmod-vga/Filer_for_Pmod VGA Reference Manual - Digilent Reference/pmodvga-0.png

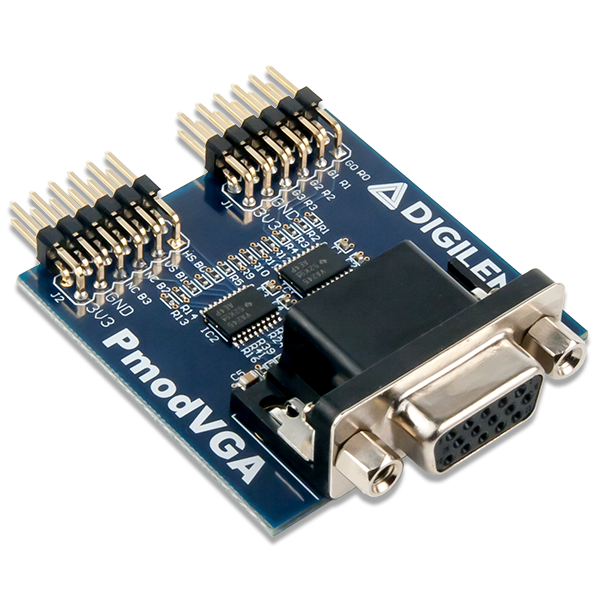
component documentation/other boards/pmod-vga/Filer_for_Pmod VGA Reference Manual - Digilent Reference/pmodvga-0.png
