halworsen/tdt4295-grafikk/component documentation/giant-gecko/stk_docs/brd2200/BRD2200A_A03_assy_draw.pdf

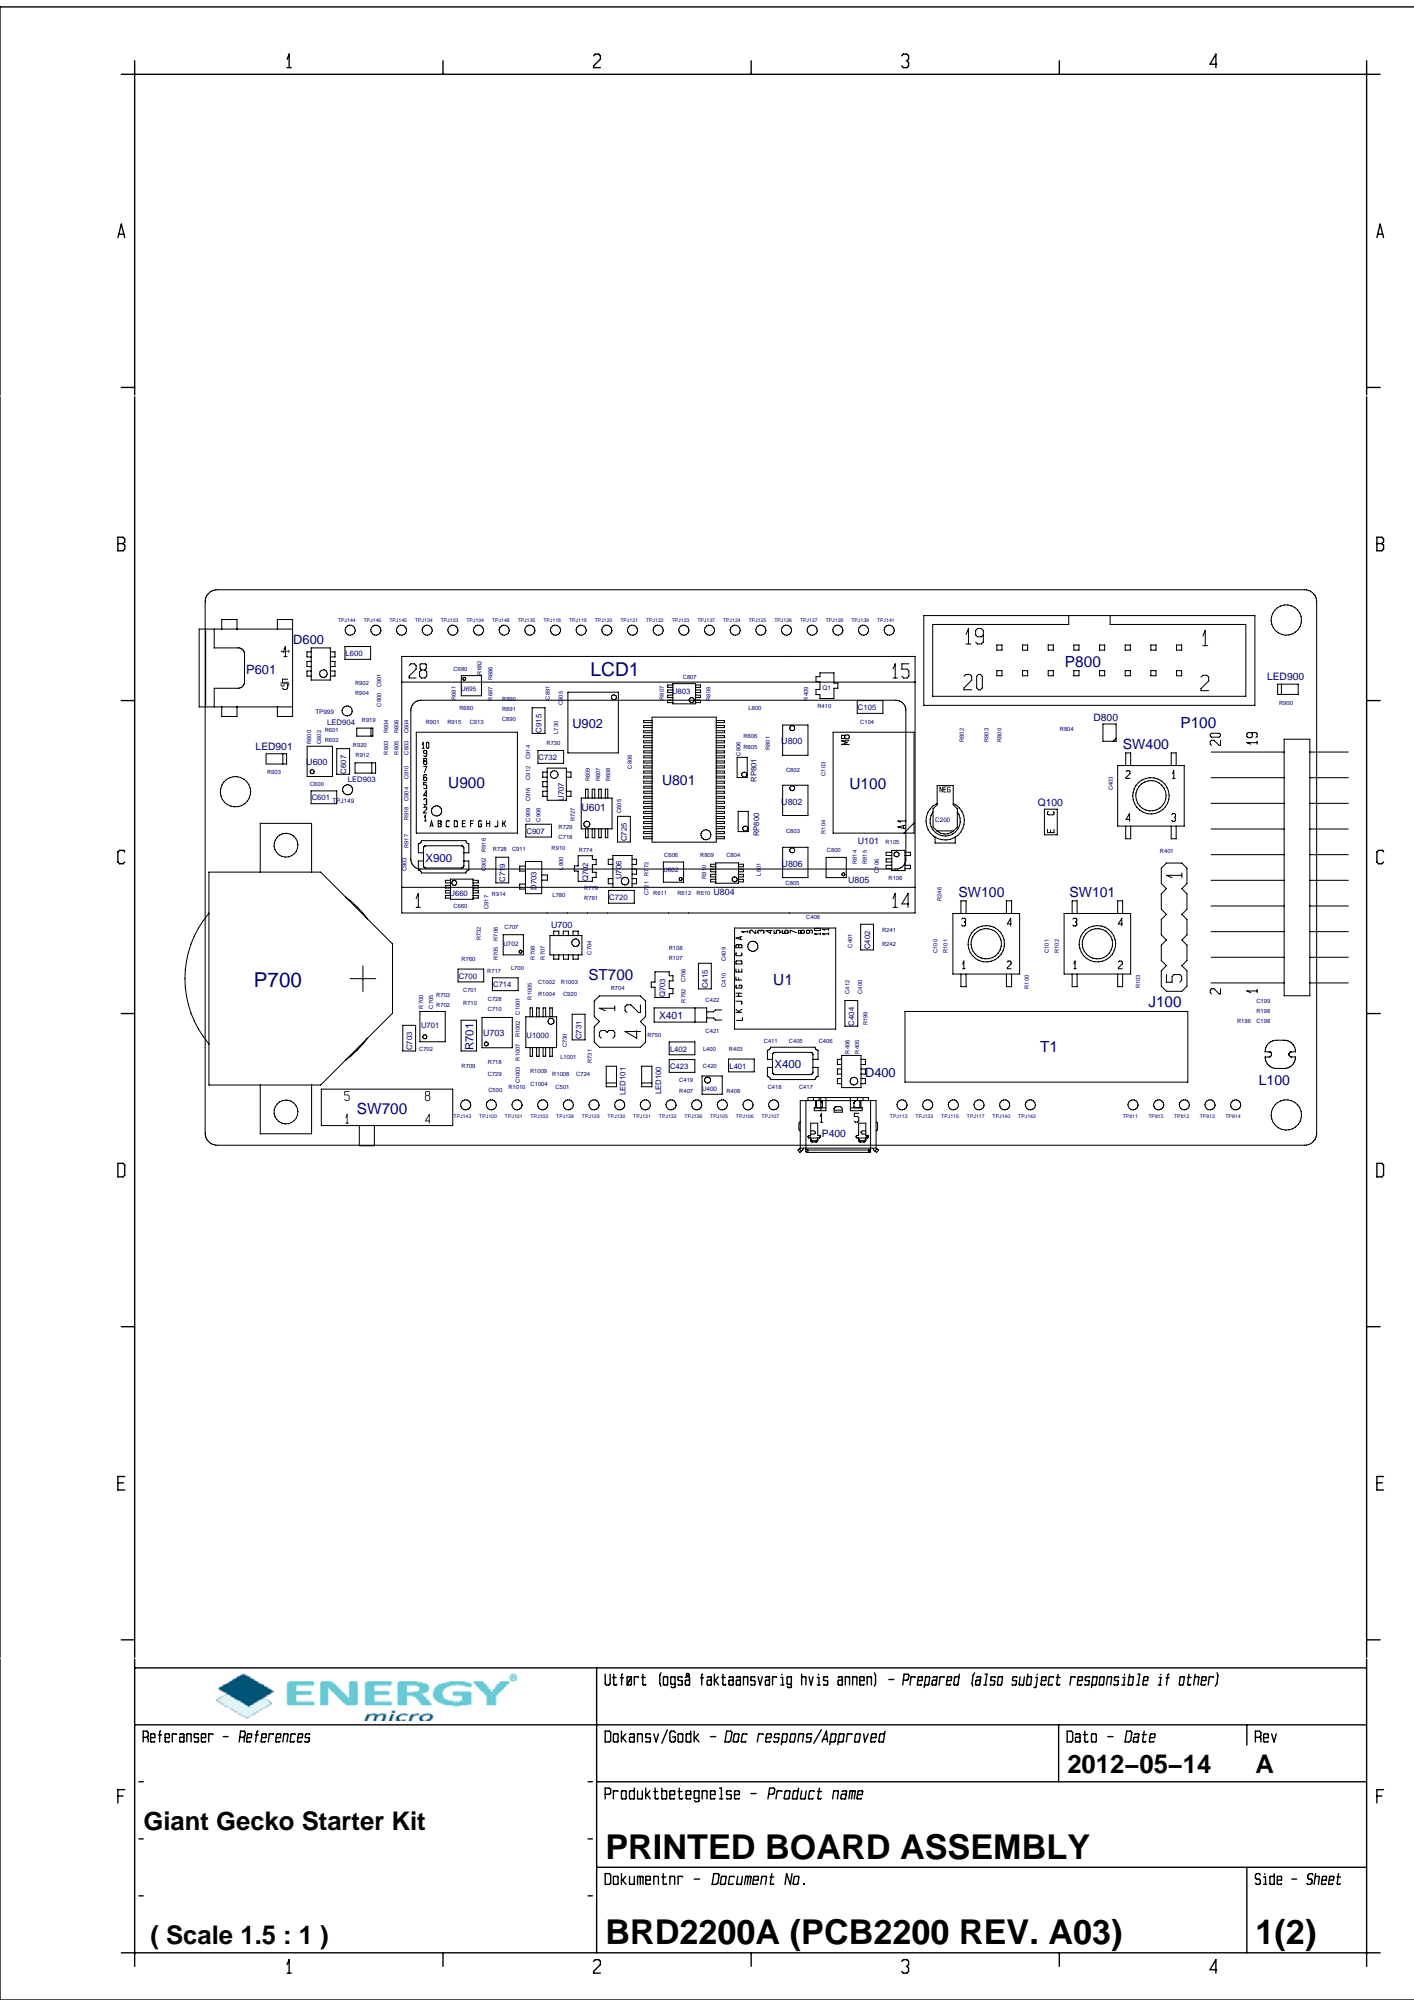
[picture p36: page 1]

Giant Gecko Starter Kit

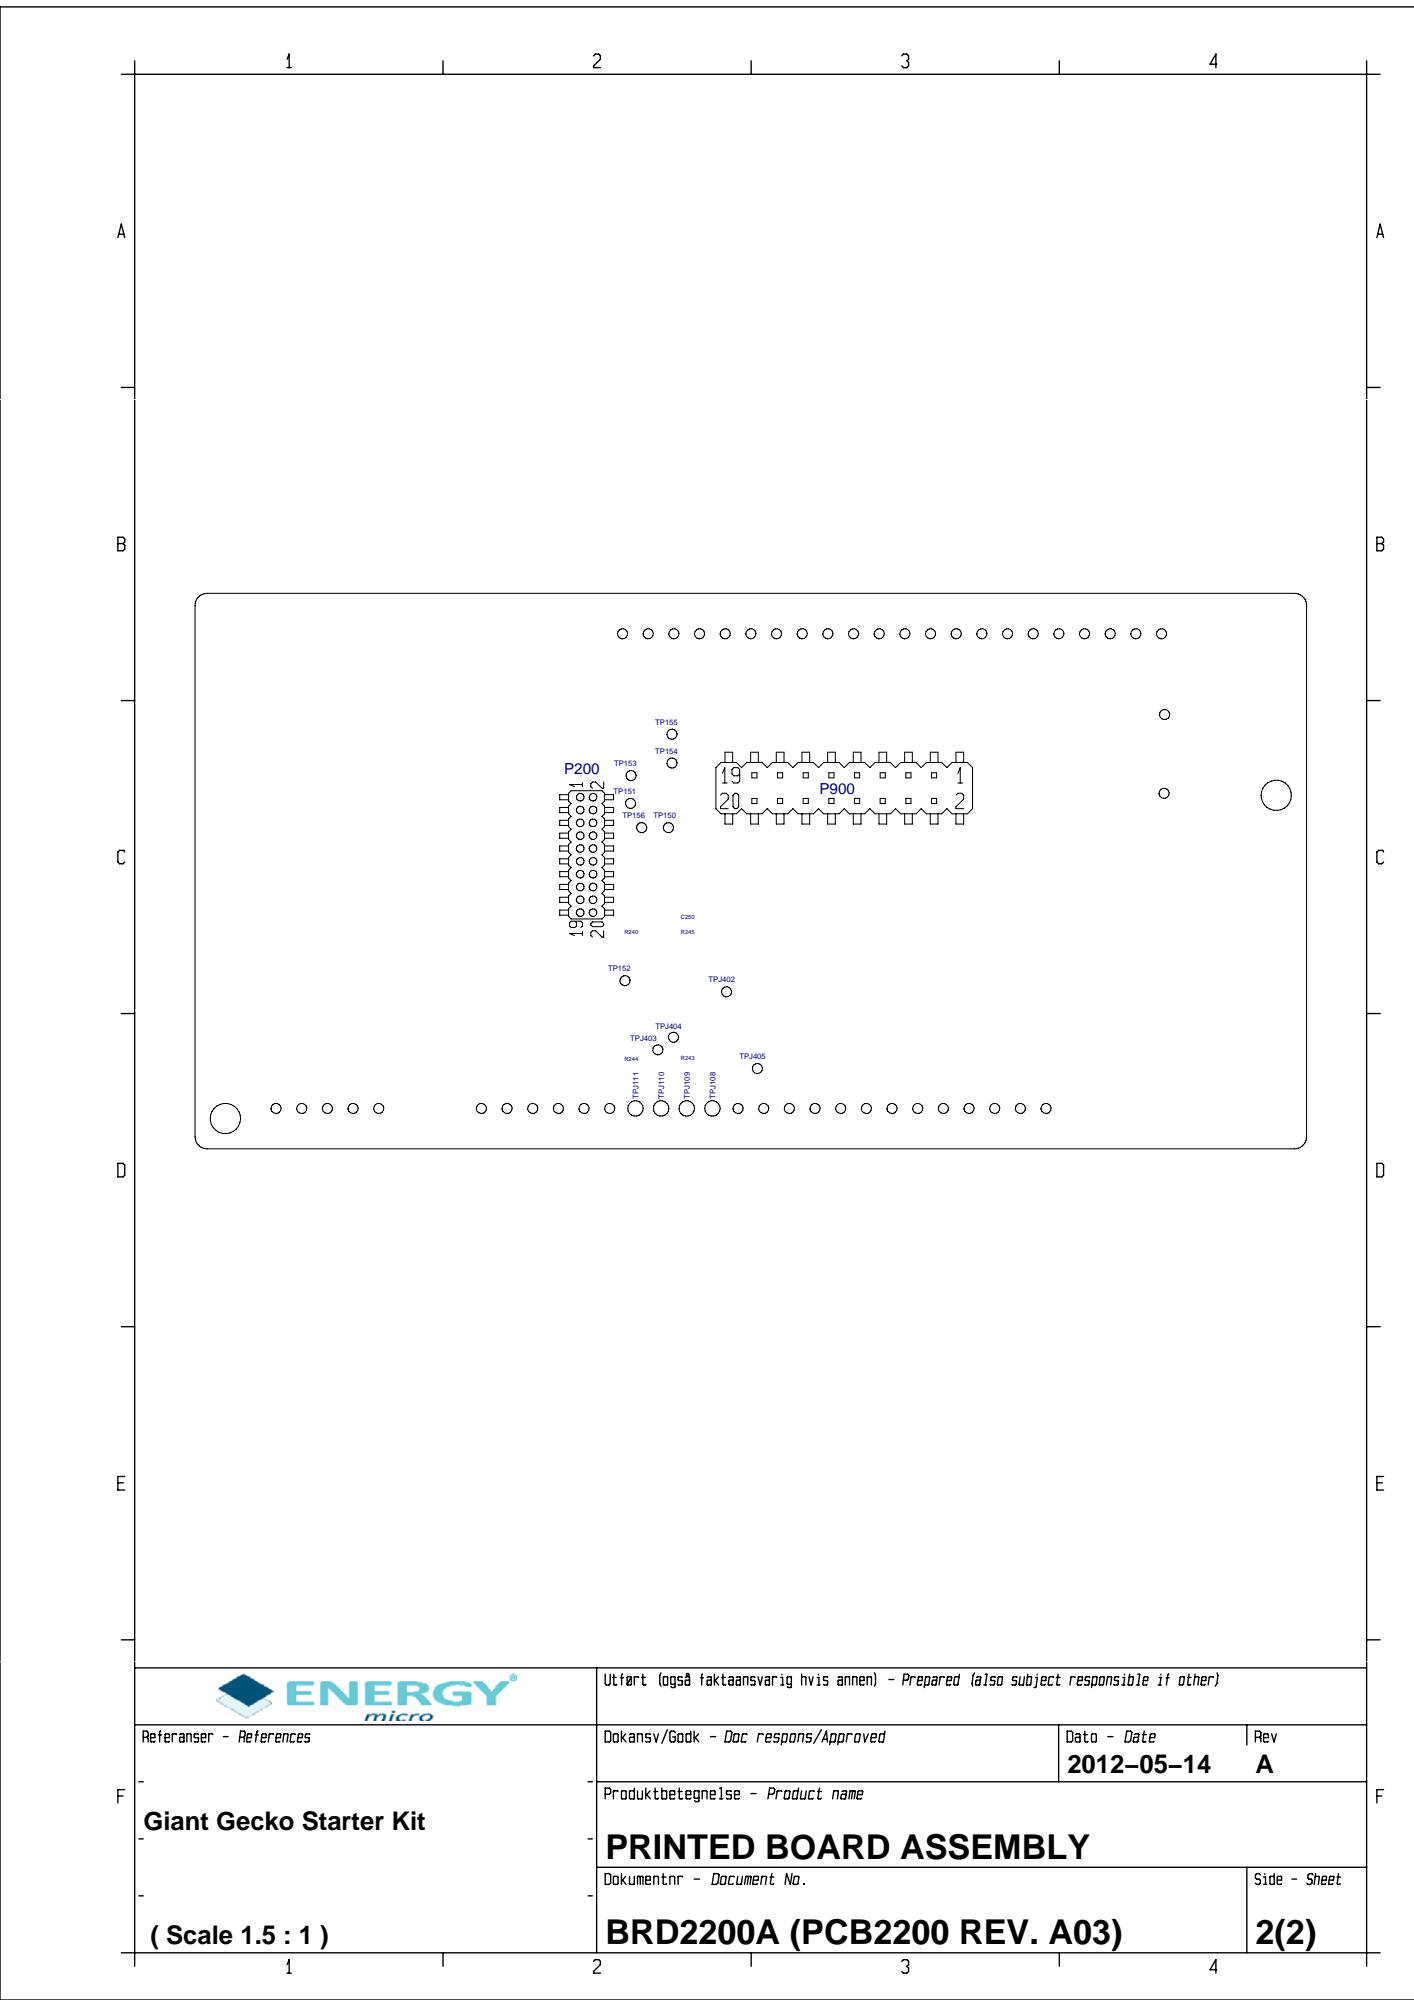
[picture p37: page 2]

Giant Gecko Starter Kit
