halworsen/tdt4295-grafikk/component documentation/giant-gecko/stk_docs/brd2201/BRD2201A_A02_assy_draw.pdf

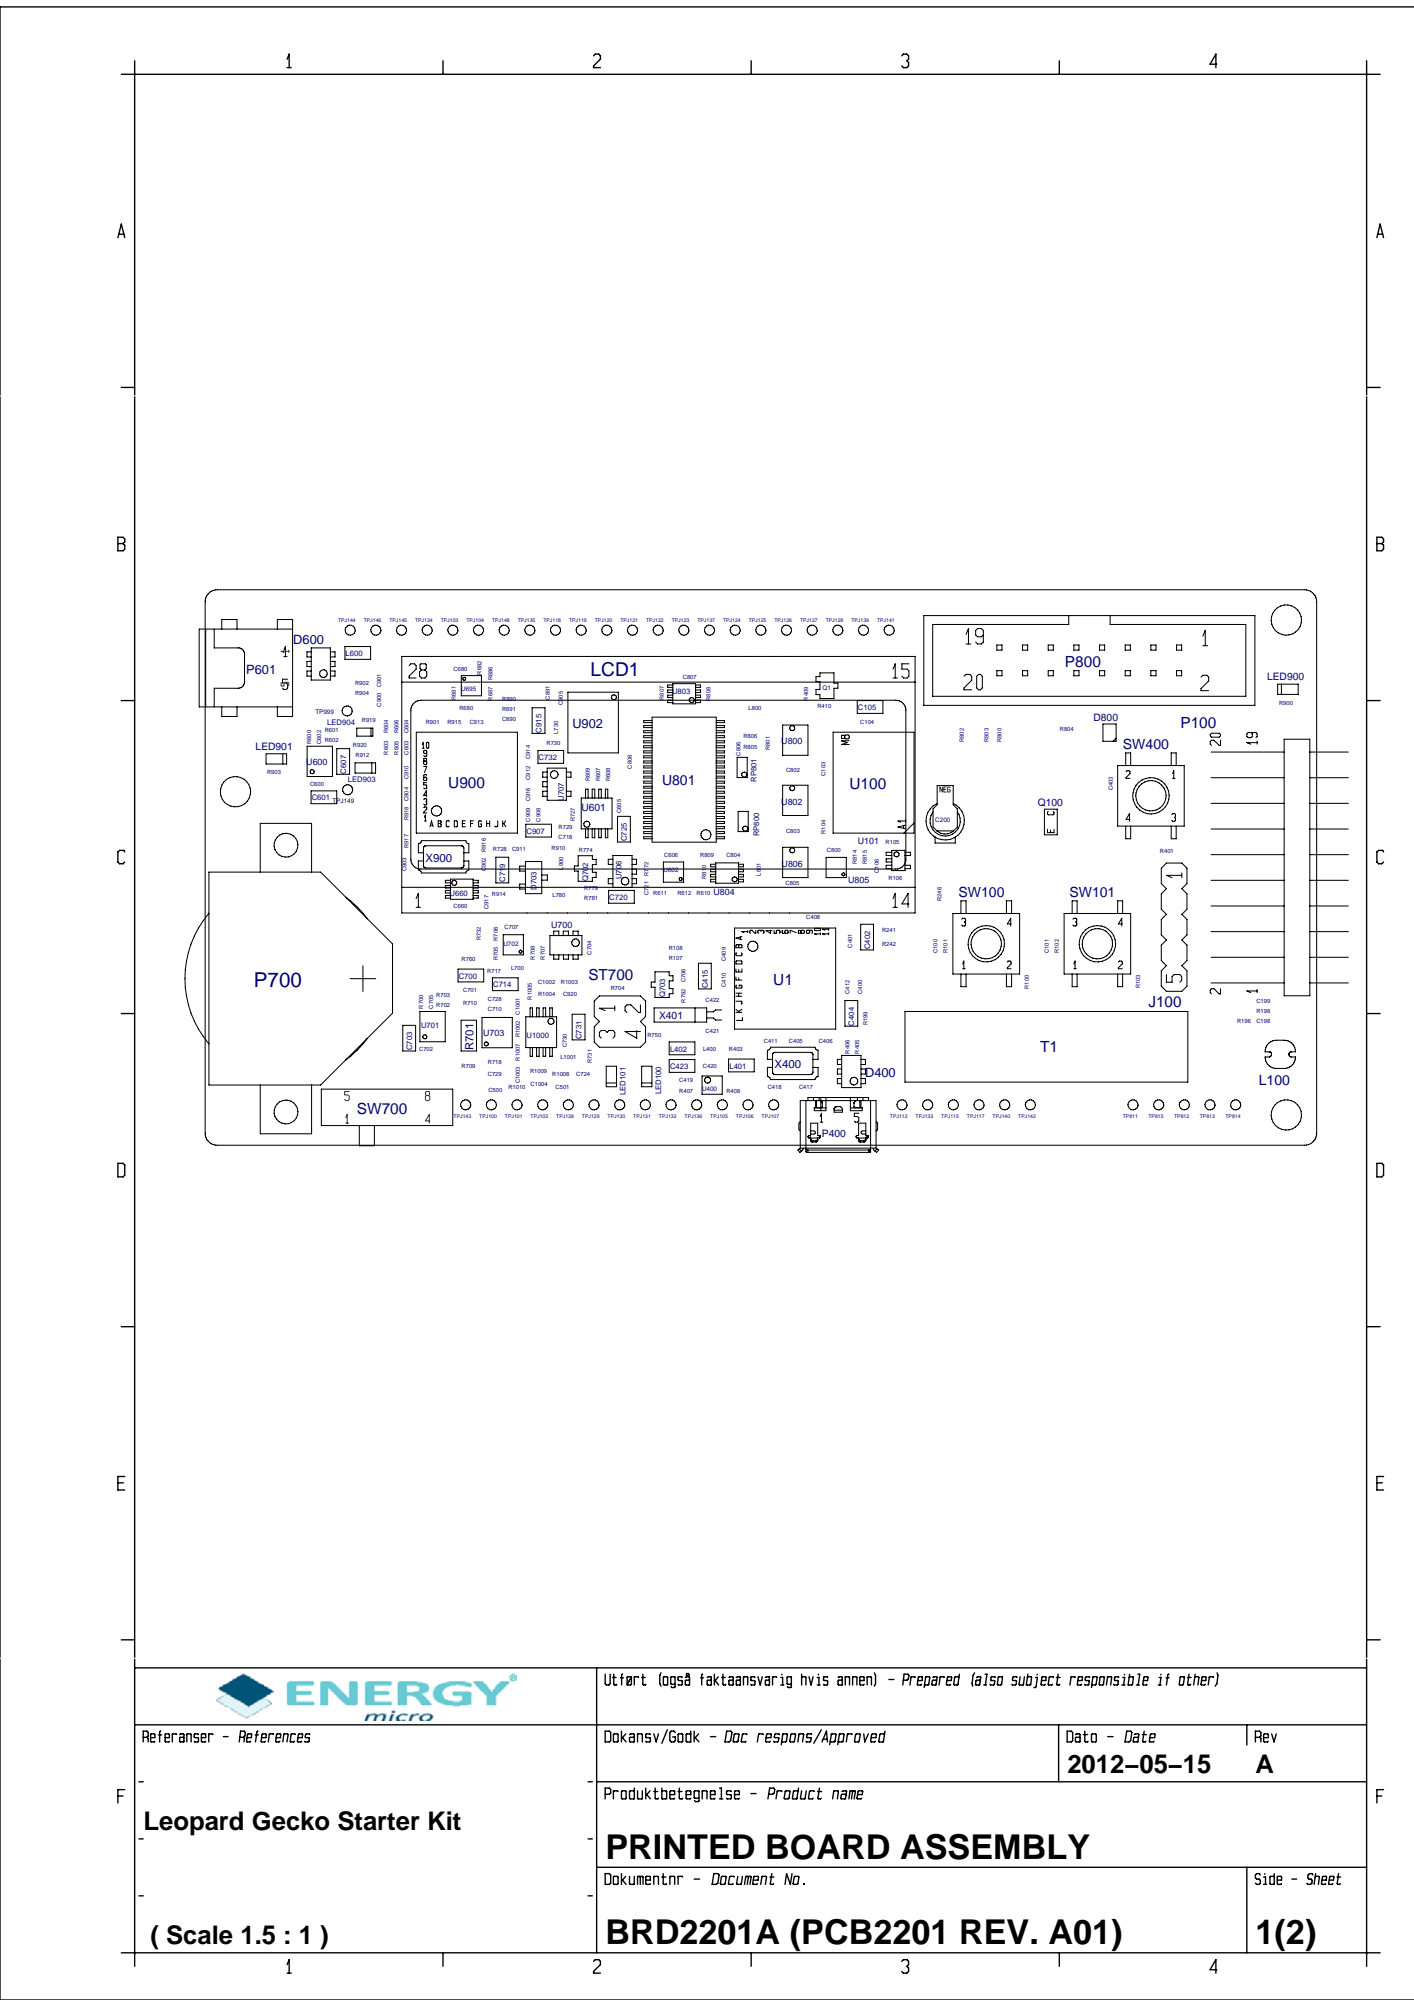
[picture p38: page 1]

Leopard Gecko Starter Kit

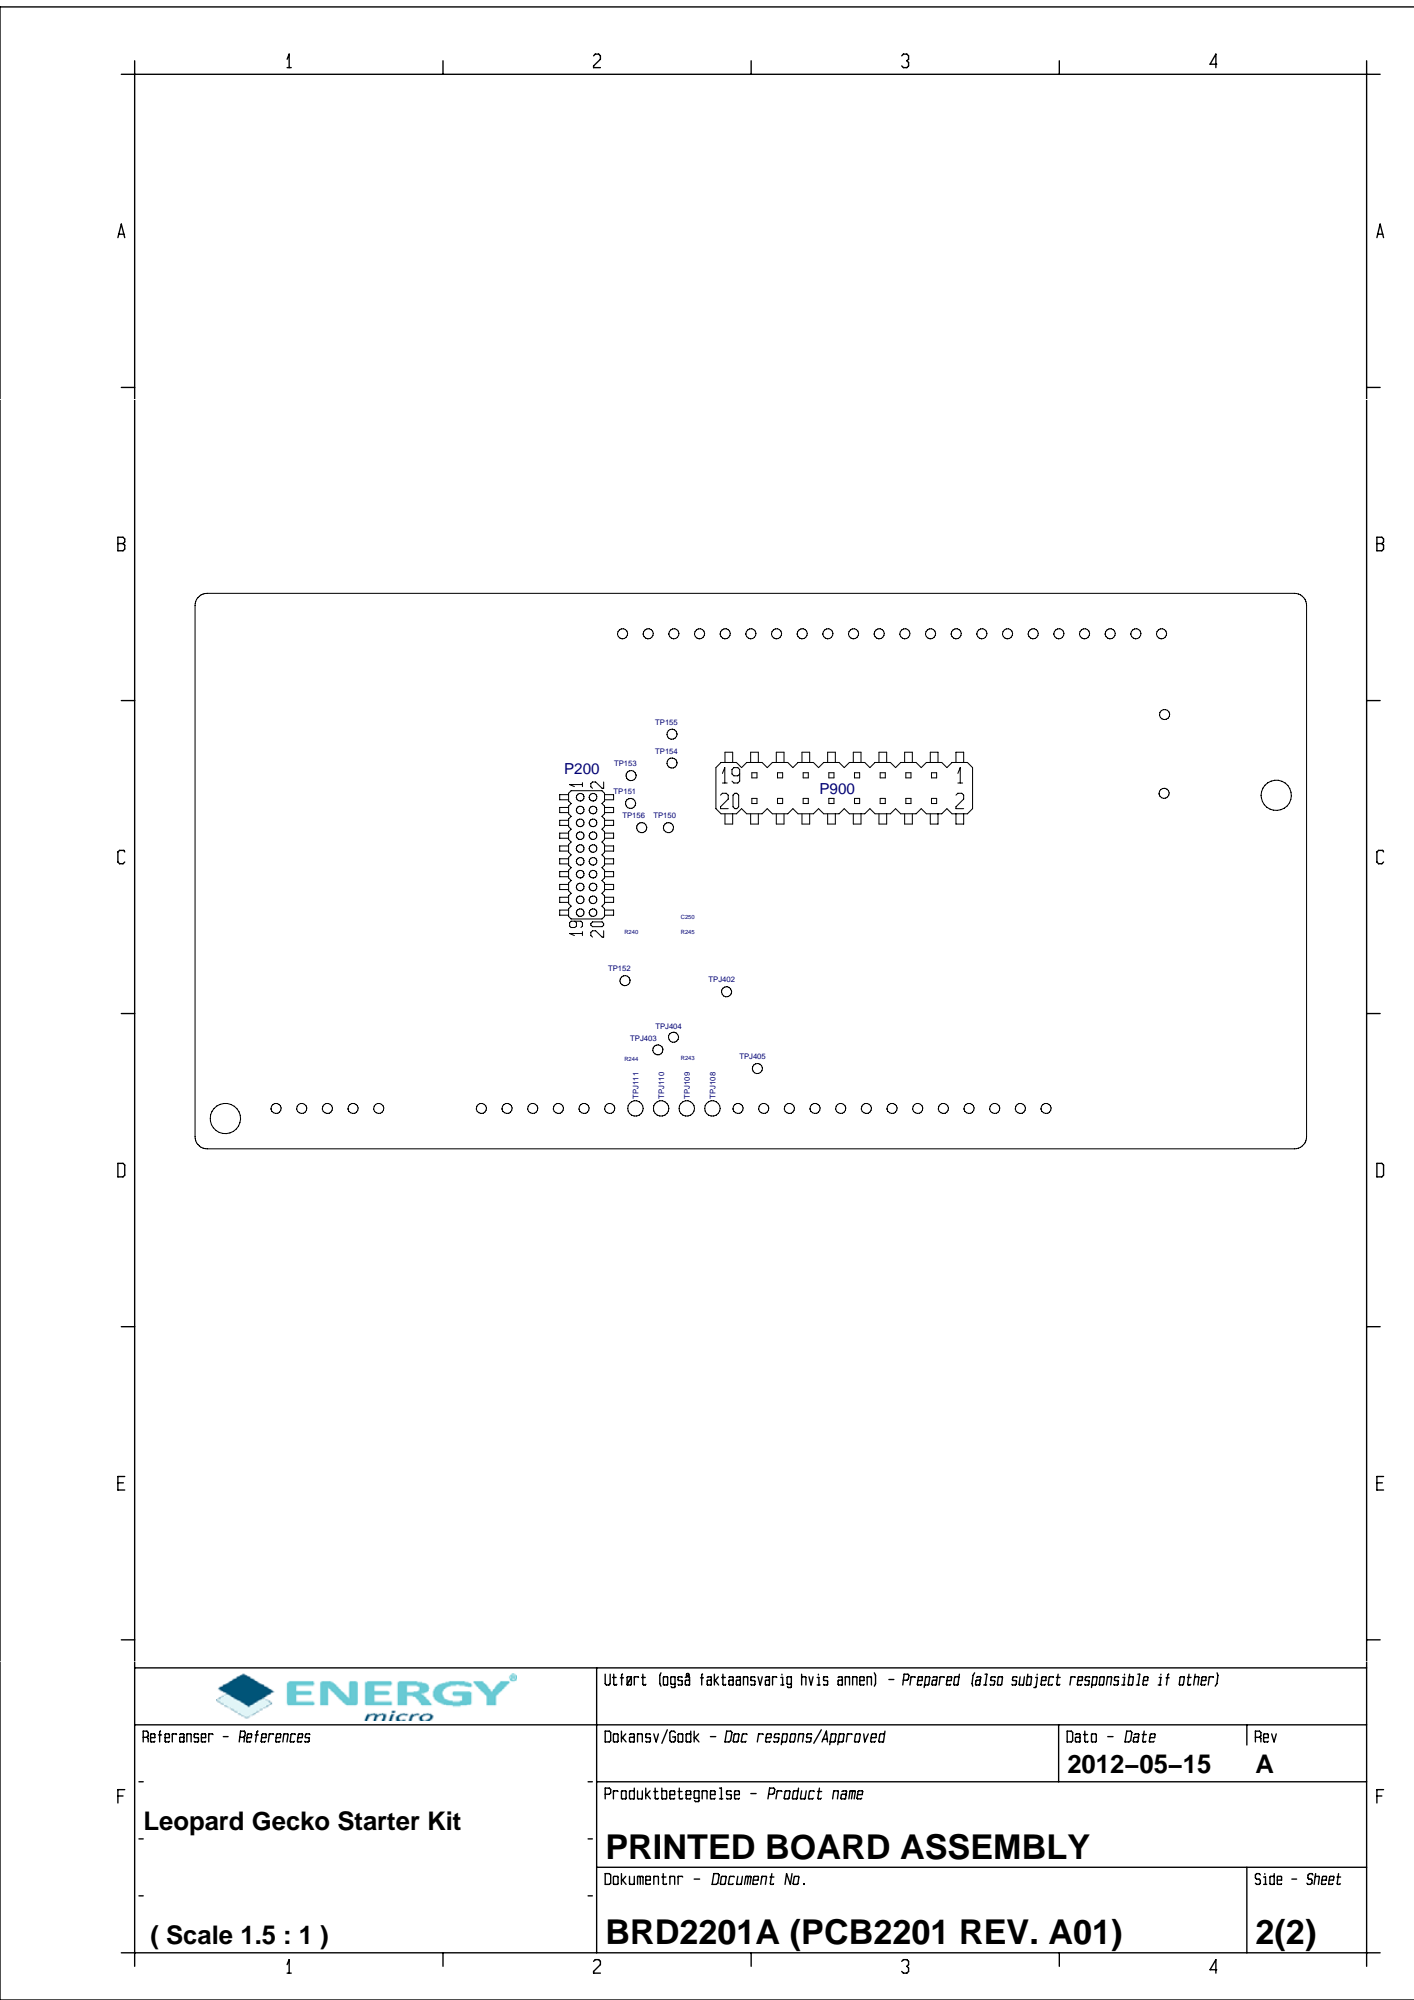
[picture p39: page 2]

Leopard Gecko Starter Kit
