halworsen/tdt4295-grafikk/pcb/tdt4295/tdt4295.kicad_pcb

## KiCad design pcb/tdt4295/tdt4295.kicad_pcb (2021-10-04)

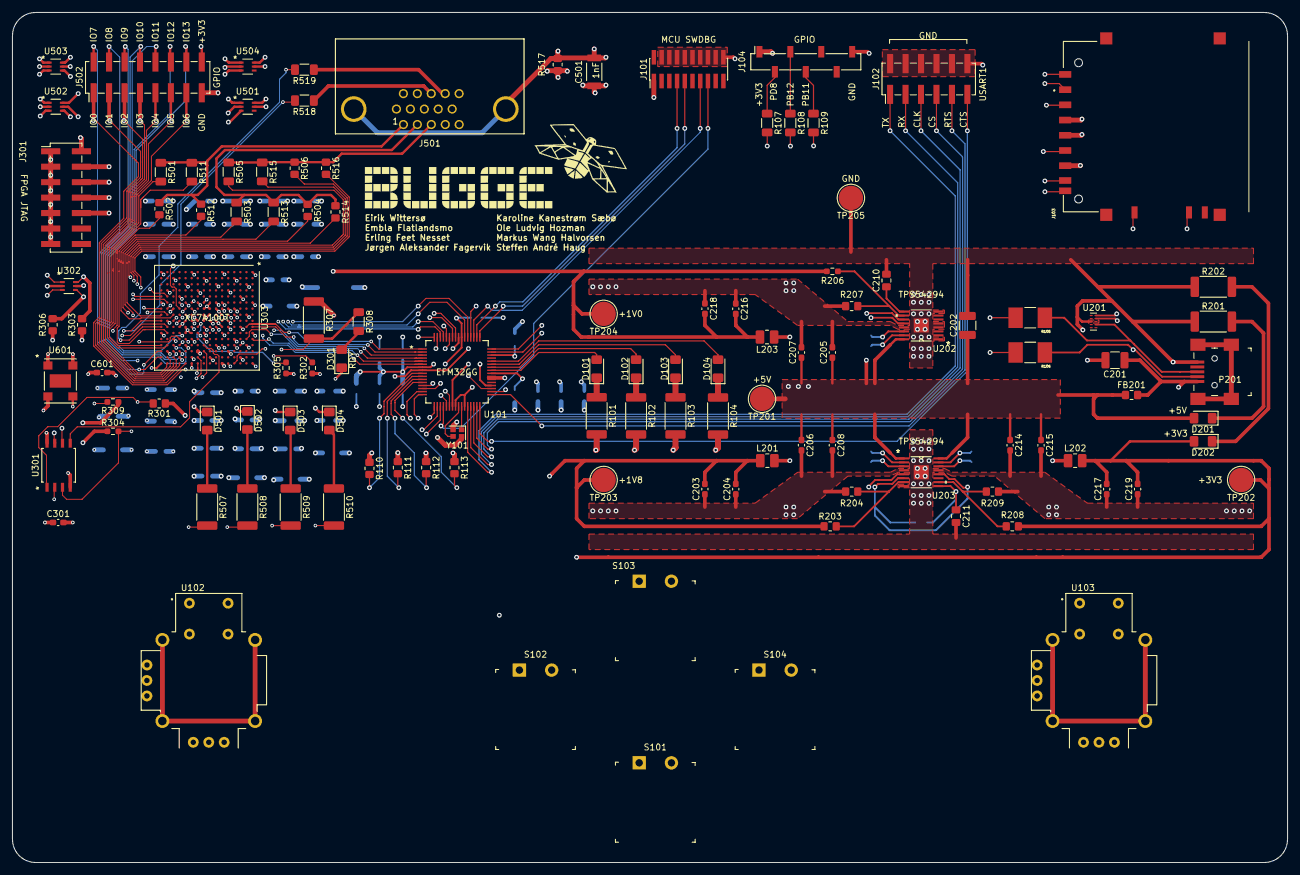
[picture p40: board tdt4295.kicad_pcb from above]

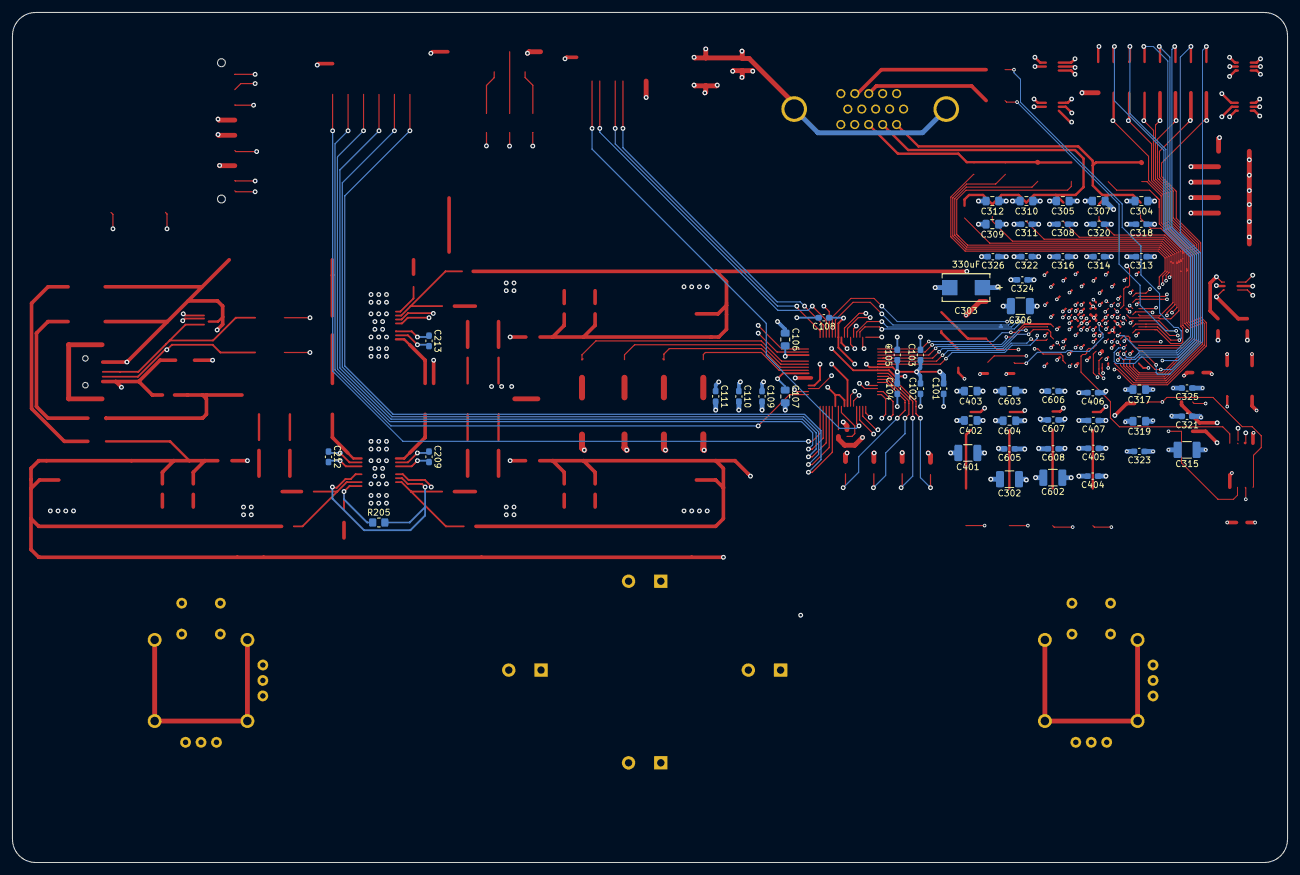
[picture p41: board tdt4295.kicad_pcb from below]

Board: 6 copper layers, 209.6 x 139.7 mm, 169 parts (54 on the bottom side), 138 nets.

Parts:
C101, C105, C108, C109, C110, C207, C208, C209, C212, C213, C215, C301, C601: 0.1uF; C_0603_1608Metric_Pad1.08x0.95mm_HandSolder
C102: 10nF; C_0603_1608Metric_Pad1.08x0.95mm_HandSolder
C103, C104, C111, C205, C206, C214: 10uF; C_0603_1608Metric_Pad1.08x0.95mm_HandSolder
C106, C107, C210, C211: 1uF; C_0805_2012Metric_Pad1.18x1.45mm_HandSolder
C201, C202, C306: 100uF; C_1210_3225Metric_Pad1.33x2.70mm_HandSolder
C203, C204, C216, C217, C218, C219: 22uF; C_0603_1608Metric_Pad1.08x0.95mm_HandSolder
C302, C315, C401, C602: 47uF; C_1210_3225Metric_Pad1.33x2.70mm_HandSolder
C303: 330uF; T520V337M2R5ATE025
C304, C305, C307, C309, C310, C312, C317, C319, C402, C403, C603, C604: 4.7uF; C_0805_2012Metric_Pad1.18x1.45mm_HandSolder
C308, C311, C313, C314, C316, C318, C320, C321, C322, C323, C324, C325, C326, C404, C405, C406, C407, C605, C606, C607, C608: 470nF; C_0603_1608Metric_Pad1.08x0.95mm_HandSolder
C501: 1nF; 8853522100131
D101, D102, D103, D104, D201, D202, D301, D501, D502, D503, D504: LED; LED_1206_3216Metric_Pad1.42x1.75mm_HandSolder
FB201: Ferrite_Bead; R_0805_2012Metric_Pad1.20x1.40mm_HandSolder
J101: ARM 20 Pin Debug Header; PinHeader_2x10_P1.27mm_Vertical_SMD
J102: MCU USART1 Header; PinHeader_2x06_P2.54mm_Vertical_SMD
J103: DM1AA-SF-PEJ(21); HRS_DM1AA-SF-PEJ(21)
J104: MCU GPIO Header; PinSocket_1x07_P2.54mm_Vertical_SMD_Pin1Right
J301: FPGA__debug; PinHeader_2x07_P2.54mm_Vertical_SMD
J501: 618015330923
J502: FPGA GPIO; PinHeader_2x08_P2.54mm_Vertical_SMD
L201, L203: 1.5uH; L_1008_2520Metric_Pad1.43x2.20mm_HandSolder
L202: 2.2uH; L_1008_2520Metric_Pad1.43x2.20mm_HandSolder
P201: 690-005-299-043; USB_Mini_B_Female_690-005-299-043
R101, R102, R103, R104, R201, R202, R507, R508, R509, R510: 330; R_2512_6332Metric_Pad1.40x3.35mm_HandSolder
R105, R106: 15; RESC6332X120N
R107, R108, R109, R308, R518, R519: 100; R_1206_3216Metric_Pad1.30x1.75mm_HandSolder
R110, R111, R112, R113, R205: 100K; R_0805_2012Metric_Pad1.20x1.40mm_HandSolder
R203: 30.1K; R_0805_2012Metric_Pad1.20x1.40mm_HandSolder
R204, R207, R209: 22.1K; R_0805_2012Metric_Pad1.20x1.40mm_HandSolder
R206: 6.81K; R_0603_1608Metric_Pad0.98x0.95mm_HandSolder
R208: 73.2K; R_0805_2012Metric_Pad1.20x1.40mm_HandSolder
R301: 2.4k; R_0805_2012Metric_Pad1.20x1.40mm_HandSolder
R302, R304, R305, R309: 4.7k; R_0603_1608Metric_Pad0.98x0.95mm_HandSolder
R303, R306: 10k; R_0805_2012Metric_Pad1.20x1.40mm_HandSolder
R307: 200; R_2512_6332Metric_Pad1.40x3.35mm_HandSolder
R501, R503, R505: 4k; R_1206_3216Metric_Pad1.30x1.75mm_HandSolder
R502, R504, R506: 1k; R_0805_2012Metric_Pad1.20x1.40mm_HandSolder
R511, R513, R515: 2k; R_1206_3216Metric_Pad1.30x1.75mm_HandSolder
R512, R514, R516: 510; R_0805_2012Metric_Pad1.20x1.40mm_HandSolder
R517: 1M; R_0805_2012Metric_Pad1.20x1.40mm_HandSolder
S101, S102, S103, S104: GPTS203211B; PushButton_12x12mm_THT_GPTS203211B
TP201, TP202, TP203, TP204, TP205: TestPoint_Probe; TestPoint_Pad_D4.0mm
U101: EFM32GG; EFM32GG12B810F1024GQ64
U102, U103: COM-09032 Joystick; XDCR_COM-09032
U201: PHDMI2AB4; DFN2510A-10
U202, U203: TPS54294; TPS54294PWP
U301: SOC008_SPA; S25FL127SABMFV101
U302, U501, U502, U503, U504: NUP4114UCW1T2G
U303: XC7A100T-FTG256-tdt4295; Xilinx_FTG256
U601: DSC1001AL5-100.0000
Y101: 48MHz; Crystal_SMD_2016-4Pin_2.0x1.6mm

Connections:
48MHZ_P1: U101.26, Y101.1
48MHZ_P3: U101.25, Y101.3
+1V0: C216.2, C218.2, C303.1, C304.1, C305.1, C306.1, C307.1, C308.1, C309.1, C310.1, C311.1, C312.1, C313.1, C314.1, C316.1, C318.1, C320.1, C322.1, C324.1, C326.1, L203.2, R206.1, TP204.1, U303.E10, U303.F7, U303.F9, U303.F11, U303.G6, U303.H9, U303.J6, U303.K9, U303.L8
+1V8: C203.2, C204.2, C315.1, C317.1, C319.1, C321.1, C323.1, C325.1, L201.1, R203.1, TP203.1, U303.G8, U303.G10, U303.J10, U303.K11, U303.L10
+3V3: C101.1, C102.1, C103.1, C104.1, C105.1, C108.1, C109.1, C110.1, C111.1, C217.2, C219.2, C301.1, C302.1, C401.1, C402.1, C403.1, C404.1, C405.1, C406.1, C407.1, C601.2, C602.1, C603.1, C604.1, C605.1, C606.1, C607.1, C608.1, D202.2, J101.1, J103.4, J104.1, J301.2, J502.16, L202.2, R110.1, R111.1, R112.1, R113.1, R208.1, R301.1, R302.1, R303.1, R304.1, R305.1, R306.1, R307.1, R309.1, TP202.1, U101.7, U101.24, U101.27, U101.38, U101.39, U101.55, U102.H1, U102.V1, U103.H1, U103.V1, U301.8, U302.5, U303.A16, U303.B13, U303.C10, U303.E7, U303.E14, U303.H15, U303.J12, U303.L6, U303.L16, U303.M9, U303.M13, U303.N10, U303.P7, U303.R14, U303.T11, U501.5, U502.5, U503.5, U504.5, U601.1, U601.4
+5V: C202.1, C205.1, C206.1, C207.1, C208.1, C214.1, C215.1, D201.2, FB201.1, TP201.1, U101.52, U202.12, U202.16, U203.1, U203.16
/FPGA/IOB14/GCLK100: U303.N12, U601.3
/FPGA/IOB14/QSPI_CS: R301.2, U301.1, U303.L12
/FPGA/IOB14/QSPI_DQ0: U301.5, U303.J13
/FPGA/IOB14/QSPI_DQ1: U301.2, U303.J14
/FPGA/IOB14/QSPI_DQ2: R304.2, U301.3, U303.K15
/FPGA/IOB14/QSPI_DQ3: R309.2, U301.7, U303.K16
/FPGA/TCK_JTAG: J301.6, R306.2, U302.4, U303.L7
/FPGA/TDI_JTAG: J301.10, U302.3, U303.N7
/FPGA/TDO_JTAG: J301.8, U302.1, U303.N8
/FPGA/TMS_JTAG: J301.4, R303.2, U302.6, U303.M7
DBG_SWCLK: J101.9, U101.49
DBG_SWDIO: J101.7, U101.50
DBG_SWO: J101.13, U101.51
FPGA_DONE: R307.2, R308.1, U101.15, U303.H10
FPGA_EXT_IO0: J502.1, U303.M12, U502.1
FPGA_EXT_IO1: J502.3, U303.M16, U502.6
FPGA_EXT_IO2: J502.5, U303.N16, U502.4
FPGA_EXT_IO3: J502.7, U303.P15, U502.3
FPGA_EXT_IO4: J502.9, U303.P16, U501.1
FPGA_EXT_IO5: J502.11, U303.R15, U501.6
FPGA_EXT_IO6: J502.13, U303.R16, U501.3
FPGA_EXT_IO7: J502.2, U303.T14, U503.1
FPGA_EXT_IO8: J502.4, U303.T15, U503.6
FPGA_EXT_IO9: J502.6, U303.N13, U503.4
FPGA_EXT_IO10: J502.8, U303.P13, U503.3
FPGA_EXT_IO11: J502.10, U303.N14, U504.1
FPGA_EXT_IO12: J502.12, U303.P14, U504.6
FPGA_EXT_IO13: J502.14, U303.N11, U504.3
FPGA_LED0: R507.2, U303.R5
FPGA_LED1: R508.2, U303.T5
FPGA_LED2: R509.2, U303.R6
FPGA_LED3: R510.2, U303.R7
FPGA_MCU_GPIO_0: U101.62, U303.C13
FPGA_MCU_GPIO_1: U101.61, U303.F13
FPGA_MCU_GPIO_2: U101.54, U303.E16
FPGA_MCU_GPIO_3: U101.53, U303.D16
FPGA_MCU_USART_CLK: U101.3, U303.D13
FPGA_MCU_USART_CS: U101.4, U303.B12
FPGA_MCU_USART_CTS: U101.6, U303.D8
FPGA_MCU_USART_RTS: U101.5, U303.A12
FPGA_MCU_USART_RX: U101.1, U303.B10
FPGA_MCU_USART_TX: U101.2, U303.A10
FPGA_PROGRAM_B: R302.2, U101.16, U303.L9
GND: C101.2, C102.2, C103.2, C104.2, C105.2, C106.2, C107.2, C108.2, C109.2, C110.2, C111.2, C201.2, C202.2, C203.1, C204.1, C205.2, C206.2, C207.2, C208.2, C210.2, C211.2, C214.2, C215.2, C216.1, C217.1, C218.1, C219.1, C301.2, C302.2, C303.2, C304.2, C305.2, C306.2, C307.2, C308.2, C309.2, C310.2, C311.2, C312.2, C313.2, C314.2, C315.2, C316.2, C317.2, C318.2, C319.2, C320.2, C321.2, C322.2, C323.2, C324.2, C325.2, C326.2, C401.2, C402.2, C403.2, C404.2, C405.2, C406.2, C407.2, C501.1, C601.1, C602.2, C603.2, C604.2, C605.2, C606.2, C607.2, C608.2, D301.1, D501.1, D502.1, D503.1, D504.1, J101.4, J101.6, J101.8, J101.10, J101.12, J101.14, J101.16, J101.18, J101.20, J102.2, J102.4, J102.6, J102.8, J102.10, J102.12, J103.3, J103.6, J104.7, J301.1, J301.3, J301.5, J301.7, J301.9, J301.11, J301.13, J501.5, J501.6, J501.7, J501.8, J501.10, J502.15, P201.5, R101.2, R102.2, R103.2, R104.2, R201.2, R202.2, R204.2, R207.2, R209.2, R517.1, S101.2, S102.2, S103.2, S104.2, TP205.1, U101.8, U101.23, U101.36, U101.56, U102.H3, U102.V3, U103.H3, U103.V3, U201.3, U201.8, U202.1, U202.4, U202.5, U202.8, U202.13, U202.EPAD, U203.4, U203.8, U203.13, U203.EPAD, U301.4, U302.2, U303.A1, U303.A6, U303.A11, U303.B3, U303.B8, U303.C5, U303.C15, U303.D2, U303.D7, U303.D12, U303.E4, U303.E9, U303.F1, U303.F6, U303.F8, U303.F10, U303.F16, U303.G3, U303.G7, U303.G9, U303.G13, U303.H6, U303.H7, U303.H8, U303.J2, U303.J7, U303.J8, U303.J9, U303.J11, U303.K4, U303.K6, U303.K14, U303.L1, U303.L11, U303.L15, U303.M3, U303.M8, U303.M10, U303.M11, U303.N5, U303.N15, U303.P2, U303.P12, U303.R4, U303.R9, U303.T1, U303.T6, U303.T16, U501.2, U502.2, U503.2, U504.2, U601.2, Y101.2, Y101.4
GPIO_BTN0: R110.2, S101.1, U101.9
GPIO_BTN1: R111.2, S102.1, U101.10
GPIO_BTN2: R112.2, S103.1, U101.11
GPIO_BTN3: R113.2, S104.1, U101.12
GPIO_JSH0: U101.19, U102.H2
GPIO_JSH1: U101.17, U103.H2
GPIO_JSV0: U101.18, U102.V2
GPIO_JSV1: U101.34, U103.V2
GPIO_LED0: D101.2, U101.41
GPIO_LED1: D102.2, U101.42
GPIO_LED2: D103.2, U101.43
GPIO_LED3: D104.2, U101.44
GPIO_PB11: R109.2, U101.21
GPIO_PB12: R108.2, U101.22
GPIO_PD8: R107.2, U101.35
MCU_RESETN: J101.15, U101.20
unnamed: C106.1, U101.46
unnamed: C107.1, U101.40
unnamed: C201.1, FB201.2, P201.1, U201.2
unnamed: C209.1, U203.2
unnamed: C209.2, L201.2, U203.3
unnamed: C210.1, U202.9
unnamed: C211.1, R205.1, U203.9
unnamed: C212.1, U203.15
unnamed: C212.2, L202.1, U203.14
unnamed: C213.1, L203.1, U202.14
unnamed: C213.2, U202.15
unnamed: C501.2, J501.SHELL, J501.SHELL1, R517.2
unnamed: D101.1, R101.1
unnamed: D102.1, R102.1
unnamed: D103.1, R103.1
unnamed: D104.1, R104.1
unnamed: D201.1, R201.1
unnamed: D202.1, R202.1
unnamed: D301.2, R308.2
unnamed: D501.2, R507.1
unnamed: D502.2, R508.1
unnamed: D503.2, R509.1
unnamed: D504.2, R510.1
unnamed: J104.2, R107.1
unnamed: J104.3, R108.1
unnamed: J104.4, R109.1
unnamed: J501.1, R501.1, R502.1, R511.1, R512.1
unnamed: J501.2, R503.1, R504.1, R513.1, R514.1
unnamed: J501.3, R505.1, R506.1, R515.1, R516.1
unnamed: J501.13, R518.1
unnamed: J501.14, R519.1
unnamed: R105.2, U101.48
unnamed: R106.2, U101.47
unnamed: R203.2, R204.1, U203.7
unnamed: R205.2, U203.6, U203.12
unnamed: R206.2, R207.1, U202.10
unnamed: R208.2, R209.1, U203.10
unnamed: R305.2, U303.K10
unnamed: U102.S1, U102.S2, U102.S3, U102.S4
unnamed: U103.S1, U103.S2, U103.S3, U103.S4
unnamed: U301.6, U303.E8
R1_PG: U202.11, U203.5
SDIO_CD: J103.10, U101.13
SDIO_CLK: J103.5, U101.63
SDIO_CMD: J103.2, U101.64
SDIO_DAT0: J103.7, U101.60
SDIO_DAT1: J103.8, U101.59
SDIO_DAT2: J103.9, U101.58
SDIO_DAT3: J103.1, U101.57
SDIO_WP: J103.11, U101.14
USART1_CLK: J102.5, U101.30
USART1_CS: J102.7, U101.31
USART1_CTS: J102.11, U101.32
USART1_RTS: J102.9, U101.33
USART1_RX: J102.3, U101.29
USART1_TX: J102.1, U101.28
USB_D+: P201.3, R105.1, U201.4
USB_D-: P201.2, R106.1, U201.1
VGA_B0: R505.2, U303.N9
VGA_B1: R515.2, U303.P9
VGA_B2: R506.2, U303.M6
VGA_B3: R516.2, U303.N6
VGA_G0: R503.2, U303.P8
VGA_G1: R513.2, U303.R8
VGA_G2: R504.2, U303.T7
VGA_G3: R514.2, U303.T8
VGA_HS: R518.2, U303.T9
VGA_R0: R501.2, U303.R13
VGA_R1: R511.2, U303.T13
VGA_R2: R502.2, U303.R10
VGA_R3: R512.2, U303.R11
VGA_VS: R519.2, U303.T10
