halworsen/tdt4295-grafikk/mcu/application/gpio.h

#ifndef LED0_PIN
#define LED0_PIN 4
#define LED1_PIN 5
#define LED2_PIN 6
#define LED3_PIN 7

#define BTN0_PIN 3
#define BTN1_PIN 4
#define BTN2_PIN 5
#define BTN3_PIN 6

#define FPGA_DONE_PIN 7
#endif

void initGPIO(void);
