halworsen/tdt4295-grafikk/mcu/application/figures.h

#include "serialize.h"
void init_figures1(struct fpga_package *figures);
void init_figures2(struct fpga_package *figures);
void init_figures3(struct fpga_package *figures);
void init_figures4(struct fpga_package *figures);
