halworsen/tdt4295-grafikk/(commit log)

2021-09-07 init kicad project for pcb
    [tdt4295.kicad_pcb, tdt4295.sch]
2021-09-07 pcb: power input and 3v3 regulator
    [BRD2200A_A03_bom.xlsx, BRD2201A_A02_bom.xlsx, tdt4295.sch]
2021-09-07 fix library pathing & add pushbutton/vmcu schematics
    [VMCU.sch, pushbuttons.sch, tdt4295.sch]
2021-09-07 fix schematic sheet numbering
    [VMCU.sch, pushbuttons.sch, tdt4295.sch]
2021-09-08 init: framebuffer
2021-09-08 feat: set up new framebuffer
2021-09-08 place power components in hierarchy, upload arty documentation
    [Power_Components.sch, tdt4295.sch]
2021-09-09 add data sheets and schematics
    [BRD2200A_A03_bom.xlsx, BRD2201A_A02_bom.xlsx]
2021-09-09 feat: set up simple driver
2021-09-09 feat: timer
2021-09-14 fpga power regulator schematics
    [Power_Components.sch, VMCU.sch, pushbuttons.sch]
2021-09-14 power component hierarchical label fix
    [Power_Components.sch, tdt4295.sch]
2021-09-15 add symbols for Giant Gecko&power regulator
2021-09-15 modify power components
    [Power_Components.sch]
2021-09-16 make changes to FPGA schematics
    [Power_Components.sch, VMCU.sch, fpga.sch, pushbuttons.sch, tdt4295.sch]
2021-09-16 Line drawing (#11)
    * feat: added bresenhams line drawing algorithm to project
    * implemented assertions
    * use chisel3 assert instead
    * fix: framebuffer
    * feat: connected fb and line drawing
    * feat: vga, fb and line drawing now interacts
    * Update Main.scala
    * formatting
    * more formatting and remove gcd
    * Delete Clock.scala
    * Update LineDrawing.scala
    * removed vga test for now
2021-09-16 Fix example main code to work (dbounce, filter rising edge)
2021-09-16 start implementing FPGA spi flash
    [Power_Components.sch, VMCU.sch, fpga.sch, pushbuttons.sch, tdt4295.sch]
2021-09-16 simple efm connections
    [Power_Components.sch, tdt4295.sch]
2021-09-16 Finish labeling/connecting EFM32 pins
    [Power_Components.sch, tdt4295.sch]
2021-09-17 rework some efm wiring according to application notes
    [Power_Components.sch, tdt4295.sch]
2021-09-17 remove analog 3v3 output
    [Power_Components.sch, tdt4295.sch]
2021-09-19 fpga and vga
    [fpga.sch, fpga_iob14.sch, vga.sch]
2021-09-20 rework power regulator to only use tps54294
    [Power_Components.sch, tdt4295.sch]
2021-09-20 add probe points for all power lines
    [Power_Components.sch]
2021-09-21 fpga external pin headers
    [fpga.sch, fpga_ext_IO.sch, fpga_iob14.sch, fpga_iob15.sch, vga.sch]
2021-09-21 add another capacitor :)
    [fpga.sch, fpga_iob15.sch, vga.sch]
2021-09-22 Connect clock,vga, framebuffer and linedrawer (#14)
    * Connect clock and vga module
    * Reroute FB and linedrawer module using IO and try make it compile
    * Connect the fb and linedrawer properly
    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
2021-09-22 Add pushbuttons & LEDs to EFM32GG GPIO ports
    [tdt4295.sch]
2021-09-22 rework MCU pinning
    [Power_Components.sch, tdt4295.sch]
2021-09-22 3v3 decouplers
    [tdt4295.sch]
2021-09-22 minor schematic fixes
    [Power_Components.sch, tdt4295.sch]
2021-09-23 Add digikey footprints, implement (some) capacitor footprints in schematic
    [fpga.sch, fpga_ext_IO.sch, fpga_iob14.sch, fpga_iob15.sch]
2021-09-23 update pcb library
2021-09-23 associate symbol components
    [fpga.sch, fpga_ext_IO.sch, fpga_iob14.sch, fpga_iob15.sch, vga.sch]
2021-09-23 Major restructuring of FPGA outputs
    [fpga.sch, fpga_ext_IO.sch, fpga_iob14.sch, fpga_iob15.sch]
2021-09-23 add configuration modes
    [fpga.sch, fpga_iob14.sch]
2021-09-23 associate (most) symbols with footprints
    [fpga.sch, fpga_ext_IO.sch, fpga_iob14.sch, fpga_iob15.sch]
2021-09-24 add final footprints, tweak VGA output
    [fpga.sch, fpga_ext_IO.sch, fpga_iob14.sch, fpga_iob15.sch]
2021-09-24 Add some no connection symbols
    [fpga.sch, fpga_ext_IO.sch, fpga_iob14.sch, fpga_iob15.sch]
2021-09-24 annotation fix
    [fpga.sch]
2021-09-24 correct errors spotted by Markus
    [fpga.sch, fpga_ext_IO.sch]
2021-09-24 add joystick symbol/footprint
    [COM-09032.step]
2021-09-24 Replace PB4-7 with joysticks
    [tdt4295.sch]
2021-09-24 connect MCU to FPGA
    [Power_Components.sch, fpga.sch, fpga_ext_IO.sch, fpga_iob14.sch, fpga_iob15.sch, tdt4295.sch, vga.sch]
2021-09-24 review stuff
    [Power_Components.sch, fpga.sch, fpga_ext_IO.sch, fpga_iob14.sch, fpga_iob15.sch, tdt4295.sch, vga.sch]
2021-09-25 cut 4 gpio connections between fpga/mcu
    more flexible to keep more gpio pins on header
    [Power_Components.sch, fpga.sch, fpga_ext_IO.sch, fpga_iob14.sch, fpga_iob15.sch, tdt4295.sch]
2021-09-26 associate (some) footprints to the symbols
    [Power_Components.sch, fpga.sch, fpga_ext_IO.sch, fpga_iob14.sch, fpga_iob15.sch, tdt4295.sch]
2021-09-27 pcb: Added some more footprints/part numbers
    [Power_Components.sch, fpga.sch, fpga_ext_IO.sch, tdt4295.sch]
2021-09-27 pcb: footprints/components for everything but inductors
    [Power_Components.sch, fpga.sch, tdt4295.sch]
2021-09-27 pcb: correct vga circuit, modify resistor/capacitor sizes
    [Power_Components.sch, fpga.sch, fpga_ext_IO.sch, fpga_iob14.sch]
2021-09-27 some footprinting work
    [tdt4295.sch]
2021-09-28 MCU fixes from review comments
    [tdt4295.sch]
2021-09-28 correct capacitor values, make junctions for IOB34&35
    [fpga.sch, fpga_iob14.sch, fpga_iob15.sch]
2021-09-28 remove jumper, add pull-ups for JTAG
    [fpga.sch]
2021-09-28 add footprints, rename components
    [Power_Components.sch, fpga.sch, fpga_ext_IO.sch, fpga_iob14.sch, fpga_iob15.sch, tdt4295.sch]
2021-09-28 footprints for everything
    [Power_Components.sch, fpga.sch, fpga_ext_IO.sch, tdt4295.sch]
2021-09-28 associate component links with (almost) every component
    [Power_Components.sch, fpga.sch, fpga_ext_IO.sch, fpga_iob14.sch, tdt4295.sch]
2021-09-28 add final footprint, fix path in footprint library
    [fpga.sch, tdt4295.csv, tdt4295.sch]
2021-09-28 minor fixes and import everything into the router
    [Power_Components.sch, fpga_ext_IO.sch, tdt4295.kicad_pcb, tdt4295.sch]
2021-09-28 the absolute minimum effort on pcb routing
    [Power_Components.sch, tdt4295.kicad_pcb]
2021-09-28 rough pcb layout of power regulator footprints
    [tdt4295.kicad_pcb]
2021-09-28 very rough layout of MCU components
    [tdt4295.kicad_pcb]
2021-09-28 roughly group together the remaining components
    [tdt4295.kicad_pcb]
2021-09-29 move capacitors to the other side, create power zones for FPGA
2021-09-29 add thermal relief zoning for both voltage regulators
    [tdt4295.kicad_pcb]
2021-09-29 start routing pins out from FPGA
    [tdt4295.kicad_pcb]
2021-09-29 do a minimal amount of routing for the 2nd power regulator
    [tdt4295.kicad_pcb]
2021-09-29 correct 330 Ohm footprints, route some more FPGA
    [fpga.sch, fpga_ext_IO.sch, fpga_iob14.sch, tdt4295.kicad_pcb, tdt4295.sch]
2021-09-29 more FPGA routing
    [tdt4295.kicad_pcb]
2021-09-29 track width rules
    [tdt4295.kicad_pcb]
2021-09-29 significantly sexier power regulation
    [tdt4295.kicad_pcb]
2021-09-29 fix clearance & unconnected regulator caps
    [tdt4295.kicad_pcb]
2021-09-29 minor routing changes
    [tdt4295.kicad_pcb]
2021-09-30 draft: serialization of la structures
2021-09-30 placing out components, more routing from FPGA
    [fpga_ext_IO.sch, tdt4295.kicad_pcb]
2021-09-30 power zones on FPGA
    [tdt4295.kicad_pcb]
2021-09-30 Finish routing voltage regulators
    [tdt4295.kicad_pcb]
2021-09-30 finish routing power input
    [Power_Components.sch, tdt4295.kicad_pcb]
2021-09-30 assorted minor fixes
    [fpga.sch, fpga_ext_IO.sch, tdt4295.kicad_pcb]
2021-09-30 draw most pinouts for FPGA, place capacitors
    [fpga.sch, fpga_ext_IO.sch, tdt4295.kicad_pcb]
2021-09-30 wrap up today's shift in the coal mines
    :')
    [tdt4295.kicad_pcb]
2021-10-01 The fight is almost over!
    [tdt4295.kicad_pcb]
2021-10-01 make longest connections
    [tdt4295.kicad_pcb]
2021-10-01 tidy up routing a little bit
    [tdt4295.kicad_pcb]
2021-10-01 fix the remainder of DRC problems
    [tdt4295.kicad_pcb]
2021-10-02 more routing cleanup
    [tdt4295.kicad_pcb]
2021-10-02 touch up the silkscreen
    header annotations etc.
    [tdt4295.kicad_pcb]
2021-10-02 more routing jank fixes
    [tdt4295.kicad_pcb]
2021-10-03 put in some 3d models, mostly for fun
    [690-005-299-043--3DModel-STEP-56544.STEP, ABM11-48.000MHZ-D2X-T3--3DModel-STEP-400430.STEP, COM-09032--3DModel-STEP-56544.STEP, TPS54294PWPR.STEP, TS-1102S-B-B-B--3DModel-STEP-56544.STEP, XC7A100T-2FTG256I.STEP, dm1aa-sf-pej_21_.stp, fpga.sch]
2021-10-04 rework power planes
    [tdt4295.kicad_pcb]
2021-10-04 a little more power plane for 1v8
    [tdt4295.kicad_pcb]
2021-10-04 fix accidental missing fill
    [tdt4295.kicad_pcb]
2021-10-04 give 5V some real estate on the power layer as well
    [tdt4295.kicad_pcb]
2021-10-04 Complete BOM, add new farnell order
    [BOM.xlsx]
2021-10-06 update Bugge schematic pdf
2021-10-07 Framebuffer (#23)
    * Start implementing framebuffer in memory
    * Add verilog code for Artix7 BRAM_SPD module
    * Add systemverilog module around bram, and respective blackbox
    * Use standard memory instead ov xilinx macro.
    Make the framebuffer work! This adds a simple 640x480 framebuffer and
    connects this to the VGA module. Also adds some example memory buffers
    to load the framebuffer with sample images.
    * Fix compilation issue
    * Ignore FB test for now
    * Move btn module to it's own file
    * remove bram class
    [bram_sdp.sv, bram_sdp_custom.sv, clock_gen.sv]
2021-10-13 Revert "Framebuffer (#23)"
    This reverts commit 0c4a14a2f97e3fc215c1c88c53ebe78f934a105f.
    [bram_sdp.sv, bram_sdp_custom.sv, clock_gen.v]
2021-10-13 Start implementing framebuffer in memory
2021-10-13 Use standard memory instead ov xilinx macro.
    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
2021-10-13 Make linedrawing work with the framebuffer
    - Change most values in the linedrawing module to be SInt in order to
    more easily calculate dy & dx.
    - Also change the module to work using a state machine. This is easier
    to understand and prob faster to run as well.
2021-10-13 qspi to spi
2021-10-13 Spi Clock driven added
2021-10-13 Use chisel `Cat` for shift reg and change some timing logic
    The SPI slave receiving is now tested and working
2021-10-14 Ignore SPI test for now
2021-10-20 Add mcu code for testing SPI
2021-10-20 Add test code for timer
2021-10-20 Add ADC sampling
2021-10-20 Use separate pins for adc and spi
2021-10-21 Tweak SPI slave and add testbenches
2021-10-23 fixed loop to loop [0, 2, 4, 6]
    [main.c]
2021-10-27 Make the SPI slave work
    Also tweaks and fixes some issues in the Linedrawer and some tb stuff.
    [arty-a7-35.xdc, linedrawing_tb.sv, main_spi_tb.sv]
2021-11-03 Add testbench for vector-matrix multiplication (& fix linedrawer)
    [matrix_tb.sv]
2021-11-03 fixed race condition and buffer overflow
    [linalg.c, main.c]
2021-11-04 Fix square drawing and try matrix-vector
    matrix-vector does noe work, needs to be redone. Also adds clearing by
    redreawing for each new input from spi.
2021-11-04 Fix timing issue in linedrawer
    This issue was not apparent when drawing only in one spot, but showd
    itself when we try to clear the buffer. We set writeEnable=1 in init2
    state, before the x and y registers were fully initialized. This meant
    that it wrote to the framebuffer one cycle too early, writing the
    previous values in the x and y registers. And since writeEnable was not
    high in init3, it was set in the draw state, one cycle too late again,
    so it does not draw the first pixel either. This should fix this by
    setting writeEnable high fist in the init3 state.
    [spi_square_tb.sv]
2021-11-09 Use ADC-scan
2021-11-12 Add correct constraint file for bugge
    [bugge.xdc]
2021-11-15 Correct pins for SPI on bugge
    [bugge.xdc]
2021-11-16 Update pins to work with pcb
2021-11-16 Read joysticks, use both edges for buttons, only send when FPGA is ready
2021-11-18 Make FP calculations in matrix correct
    [matrix_tb.sv]
2021-11-18 Change to use FP entire way from SPI
    Changes to use FP through the pipeline till after rotation. Also adds a
    testbench for FP through SPI and cleans up FP a bit through the code.
2021-11-19 Use 12 BP and setup for minimal example over SPI
2021-11-19 Add matrix to dataframe over SPI & use that for MVP
2021-11-21 Calculate correct fb address & only switch buffer when needed
    The `current_buffer` bit was optimized out by chisel, due to too large
    bit widths. So the buffer was never switched for reads. This also fixes
    ghosting issued caused by always switching buffer, without clearing it.
    This will switch buffer only when clearing.
2021-11-21 Convert SPI data vectors to correct order
2021-11-21 Add support for clear commands from SPI
2021-11-21 Use SInt through entire pipeline
    This fixes the clipping issue, as we now can "draw" outside the frame,
    and control clipping when drawing to the framebuffer.
2021-11-21 remove old serialization code without byte flipping
    [serialize.c, serialize.h]
2021-11-22 Generate c files from obj files
    [Super Mario 64 - Mario.obj, mariohead.obj, star.obj]
2021-11-22 Fixed indexing
    [mariojp.obj]
2021-11-22 Implement support for clearing the framebuffer while reading
    This allows us to start clearing the framebuffer while reading, by just
    starting the clearing immediately and clear "after" the reading until
    the buffer is switched.
2021-11-22 Move entire loop back to one timer
2021-11-22 Added starfox ship
    [Arwing.obj]
2021-11-22 Flipped y coordinates of generated models
    [Peaches Castle.obj]
2021-11-22 Add debounce to buttons
2021-11-22 script takes multiple files
    [N64_mario.obj, arwing.obj, mariohead.obj, peaches_castle.obj, smash_mario.obj, star.obj]
2021-11-22 More models :)
    [link.obj, torchic.obj]
2021-11-22 Increase point and line number alot & fix some bugs
    [bugge.xdc]
2021-11-22 70 verts 100 lines per frame per frame
2021-11-23 Reset state when switching model
    [main.c]
2021-11-23 Fix Z min zoom and reset rotation in correct handler
    [main.c]
