halworsen/tdt4295-grafikk/(notices)

Notices in the files:
mcu/application/model_generation/arwing.obj:
Exported from SketchUp, (c) 2000-2012 Trimble Navigation Limited
mcu/application/model_generation/N64_mario.obj:
3ds Max Wavefront OBJ Exporter v0.97b - (c)2007 guruware
parts and their libraries:
Copyright 2021 Accelerated Designs. All rights reserved.
Copyright 2016 Accelerated Designs. All rights reserved.
